youhas97/autonom-taxi/sketch/components.txt

Sensormodul:
    -ATMega1284, AVR
        http://ww1.microchip.com/downloads/en/DeviceDoc/doc8059.pdf
    -GP2Y0A41SK, Optisk avståndsmätare 4-30 cm (höger)
        https://docs.isy.liu.se/pub/VanHeden/DataSheets/sharp-GP2Y0A41SK0F.pdf
    -GP2Y0A02YK, Optisk avståndsmätare 20-150 cm (framåt)
        https://docs.isy.liu.se/pub/VanHeden/DataSheets/gp2y0a02_e.pdf
    -Halleffektsensor (medföljer chassi)
    -LCD JM162A, 2 rader x 16 tecken
        https://docs.isy.liu.se/pub/VanHeden/DataSheets/jm162a.pdf
        https://docs.isy.liu.se/pub/VanHeden/DataSheets/hd44780_komplett.pdf

Kommunkationsmodul:
    -Raspberry Pi 3 (medföljer chassi)
        https://www.raspberrypi.org/documentation/hardware/raspberrypi/README.md
    -Raspberry Pi Camera V2 Video Module
        https://www.raspberrypi.org/documentation/hardware/camera/README.md
    -Raspberry Pi GPIO
        https://www.raspberrypi.org/documentation/hardware/raspberrypi/gpio/README.md
    -TXB0104 Level Shifter (2st)
        https://www.adafruit.com/product/1875

Styrmodul:
    -ATMega1284, AVR
    -Motor (medföljer chassi)
    -Servo (medföljer chassi)
    -JTAG ICE (debug/flashning)
    -LCD JM162A

Gemensamt:
    -IQEXO-3, Kristalloscillator
        https://docs.isy.liu.se/pub/VanHeden/DataSheets/exo3.pdf
