youhas97/autonom-taxi/doc/tekniskrapport/sections/abstract.tex

\documentclass[kravspec/krav.tex]{subfiles}

\begin{document}

\vspace*{4cm}
\renewcommand{\abstractname}{\Large Sammanfattning}
\thispagestyle{empty}
\begin{abstract}
    \vspace*{1cm} \noindent
    En autonom taxibil som navigerar i ett känt rutnät har konstruerats med
    hjälp av två mikrokontroller och en Raspberry Ii. Banan som bilen kör på är
    förutbestämd där vägmarkeringarna är markerade med tejp. Banan består inte
    av några korsningar men banan kan bestå av rondeller. Bilen använder sig av
    en kamera där bilderna behandlas för att känna igen vägmarkeringarna.
    Därefter får bilen sina reglerparametrar från bildbehandlingen och från
    IR-sensorerna. Detta dokument beskriver de tekniska detaljerna i både
    hårdvaran och mjukvaran av taxibilen.
\end{abstract}
\newpage
\end{document}
