youhas97/autonom-taxi/doc/common/format_tikz.tex

\usepackage{tikz}

\tikzstyle{module}=[
    draw,
    rectangle,
    minimum width=30mm,
    minimum height=40mm,
    text width=30mm,
    align=center
]
\tikzstyle{branch}=[fill,shape=circle,minimum size=3pt,inner sep=0pt]
