youhas97/autonom-taxi/doc/common/sections/identity.tex

\documentclass[kravspec/krav.tex]{subfiles}

%tabell för projektidentitet
\newenvironment{projektidentitet}{%
{\ }\vspace{30mm}
\renewcommand{\arraystretch}{2}
\begin{center}
  {\huge Projektidentitet\\[1ex]}
  \textsl{\VARgruppnummer, \LIPSdatum, \VARprojekttitel}\\[1cm]
    \begin{tabular}{lp{60mm}r}
      \hline
      \textbf{Namn} &
      \textbf{Ansvarsområde} &
      \textbf{Epost} \\
	\hline
      }%
      {%
      \hline
    \end{tabular}
\end{center}
}
\newcommand{\gruppmedlem}[3]{{#1} & {#2} & {#3} \\}

\begin{document}

\thispagestyle{empty}

\begin{projektidentitet}
\gruppmedlem{\VARprojektledare}{Projektledare och kundkontakt}
    {\href{mailto:\VARprojektledaremail}
    {\texttt{\VARprojektledaremail}}}
\gruppmedlem{\VARkundansvarig}{Testansvarig}
    {\href{mailto:\VARkundansvarigmail}
    {\texttt{\VARkundansvarigmail}}}
\gruppmedlem{\VARarkitekt}{Arkitekt}
    {\href{mailto:\VARarkitektmail}
    {\texttt{\VARarkitektmail}}}
\gruppmedlem{\VARdokumentansvarig}{Dokumentansvarig}
    {\href{mailto:\VARdokumentansvarigmail}
    {\texttt{\VARdokumentansvarigmail}}}
\gruppmedlem{\VARgranssnitt}{Gränssnitt}
    {\href{mailto:\VARgranssnittmail}
    {\texttt{\VARgranssnittmail}}}
\gruppmedlem{\VARhardware}{Hårdvara}
    {\href{mailto:\VARhardwaremail}
    {\texttt{\VARhardwaremail}}}
\gruppmedlem{\VARelektronik}{Elektronik}
    {\href{mailto:\VARelektronikmail}
    {\texttt{\VARelektronikmail}}}
\end{projektidentitet}

\begin{center}
\vspace{0.5cm}
{\href{mailto:\VARdokumentansvarigmail,\VARarkitektmail,\VARprojektledaremail,
    \VARgranssnittmail,\VARprojektledaremail,\VARhardwaremail,
    \VARelektronikmail,\VARkundansvarigmail}{
\texttt{E-postadress till gruppen}}}\\

{\href{\VARgrupphemsida}{
\texttt{Grupphemsida: Git-repo för projekt}}}\\[1cm]

{\textbf{Kund:} \VARbestallare}\\[0.5ex]
{\textbf{Kontaktperson hos kund:} \VARkontaktperson}\\[1cm]

{\textbf{Kursansvarig:} \VARkursansvarig}\\[1ex]
{\textbf{Handledare:} \VARhandledare}

\end{center}
\newpage
\end{document}
