youhas97/autonom-taxi/doc/common/sections/frontpage.tex

\documentclass[kravspec/krav.tex]{subfiles}

\begin{document}
\begin{titlepage}
\thispagestyle{empty}
\begin{center}
    %logo
    \\[1.0cm]

    %heading
    \textsc{\Large TSEA29}\\[1.5cm]
    \textsc{\large Konstruktion med mikrodatorer}\\[2cm]
    
    %title
    { \huge \bfseries \LIPSdokumenttyp}\\[0.6cm]
    { \LARGE \VARprojekttitel}\\[2cm]

    %date
    {\large \LIPSdatum}\\[2ex]
    {\textbf{Redaktör: \VARprojektledare}}\\[2ex]
    {\VARgruppnummer}\\[2ex]
    {\textsl Version \LIPSversion}\\[2cm]

    {\large Status}\\[1.5ex]
    {\renewcommand{\arraystretch}{1.6}
    \begin{tabular}{|*{3}{p{40mm}|}}
    \hline
    Granskad & \LIPSgranskare & \LIPSgranskatdatum \\
    \hline
    Godkänd & \LIPSgodkannare & \LIPSgodkantdatum \\
    \hline
    \end{tabular}
    }
    
\end{center}
\end{titlepage}
\newpage

\end{document}
