youhas97/autonom-taxi/doc/tekniskrapport/figures/SequenceDiagramClient.pdf

## Fjärrklient

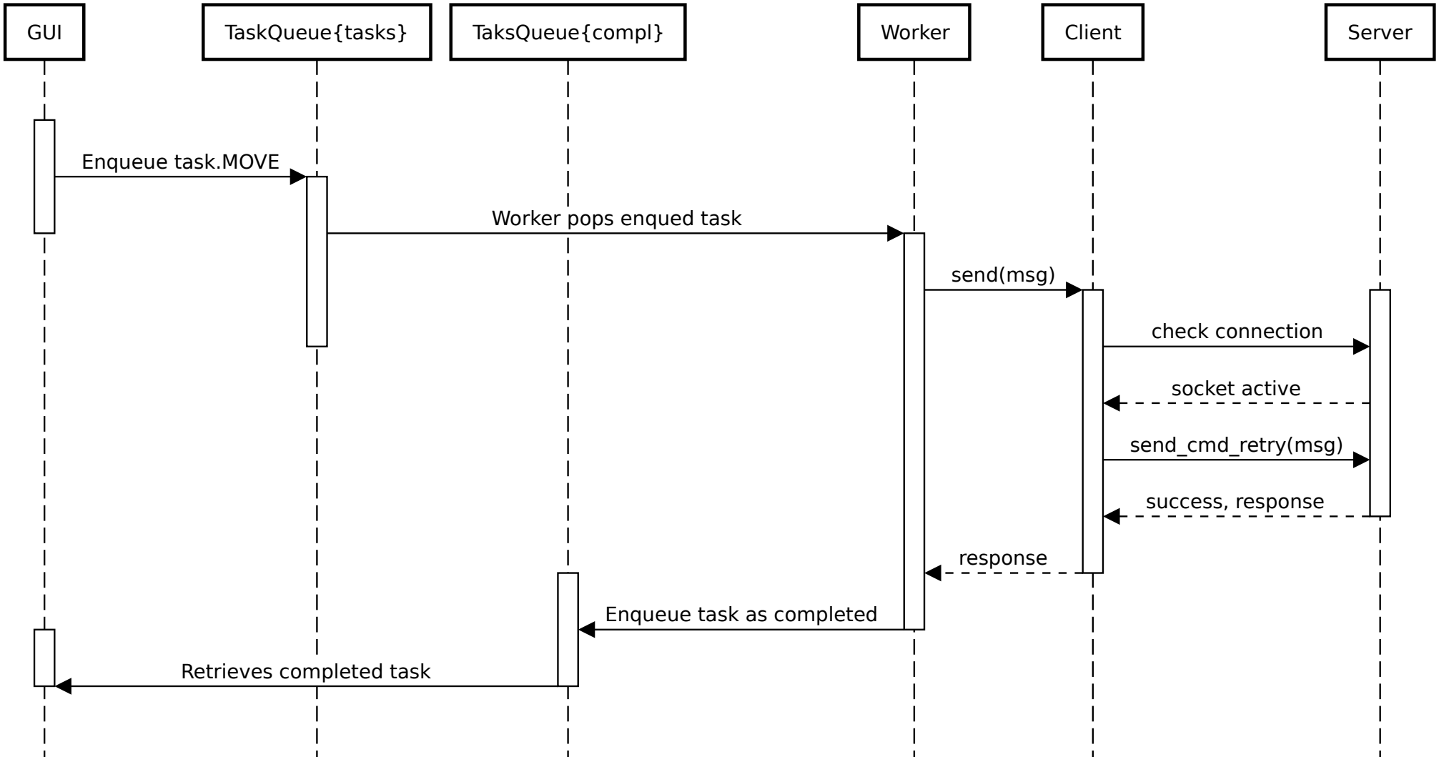
[picture p11: figure]
GUI; TaskQueue{tasks}; TaksQueue{compl}; Worker; Client; Server; Enqueue task.MOVE; Worker pops enqued task; send(msg); check connection; socket active; send_cmd_retry(msg); success, response; response; Enqueue task as completed; Retrieves completed task
