youhas97/autonom-taxi/doc/tekniskrapport/sections/appendices.tex

\documentclass[main.tex]{subfiles}
\renewcommand\appendixtocname{Bilagor}

\begin{document}

\pagestyle{empty}

\begin{appendices}
    \newpage
    \section{Bilaga. Kommandon för SPI}
    \label{bcmds}
    \input{tekniskrapport/figures/bcmds.tex}

    \newpage
    \section{Bilaga. Kommandon för server}
    \label{scmds}
    \input{tekniskrapport/figures/scmds.tex}

    \begin{landscape}
    \section{Bilaga. Kretsscheman}
    
    \subsection{Kommunikationsmodul}
    \label{cdiag:comm}
	    

    \subsection{Styrmodul}
    \label{cdiag:ctrl}
	    

    \subsection{Sensormodul}
    \label{cdiag:sens}
	    

    \end{landscape}
\end{appendices}

\end{document}
