youhas97/autonom-taxi/doc/tekniskrapport/sections/theory.tex

\documentclass[\docdir/tech.tex]{subfiles}

\begin{document}

\section{Teori}
Projektet använder vissa redan existerande funktioner och bibliotek för att
underlätta arbetet för projektgruppen. Nedan finns förklaringar på hur dessa
fungerar.

\subsection{PD-regulator}

Regleringen fungerar genom att räkna ut ett värde $v[n]$ med hjälp av ett
felvärde $e[t]$ så att 
\begin{equation*} v[n] = k_p \cdot e[n] + k_d \cdot (e[n]-e[n-1])\end{equation*} 
där $k_p$ och $k_d$ är konstanter(K-proportionell och K-derivata). Den första
termen står för att justera utefter det nuvarande felet. Den andra termen står
för att justera utefter den nuvarande förändringen av felet.

\end{document}
