youhas97/autonom-taxi/doc/kravspec/sections/requirements.tex

\documentclass[kravspec/krav.tex]{subfiles}

\begin{document}
\clearpage
\section{Prestandakrav}
Nedan följer de prestandakrav taxibilen bör uppnå vid avslutat projekt.

\begin{reqlist}
    \req{Bilen ska under fyra försök klara av att utföra ett uppdrag, som
    specificerat i banspecifikationen, åtminstone tre gånger.
    Banspecifikationen skickas in separat till beställaren.}
    \req{Bilen ska endast använda kortaste vägen under uppdraget.}
    \reqspec{original}{2}{Bilen ska klara uppdraget fyra gånger på fyra försök.}
\end{reqlist}

\section{Krav på utökning}
Nedan följer de krav som berör möjligheten att utöka enheten efter att
produkten är levererad.

\begin{reqlist}
    \req{Enheten ska bestå av separata moduler som kommunicerar via ett
    gränssnitt för att tillåta smidiga utbyten av moduler. Gränssnittet
    specificeras i det tekniska dokumentet.}
\end{reqlist}

\section{Resurser}
Projektgruppen skall hålla sig inom följande resurskrav.

\begin{reqlist}
    \req{Projektgruppens medlemmar skall spendera 160 timmar vardera på
    projektet efter beslutspunkt 2.}
\end{reqlist}

\section{Leveranskrav}
Följande leveranskrav skall uppnås.

\begin{reqlist}
    \req{Tidsrapporter som redovisar föregående veckas arbetad tid ska
    levereras varje måndag från och med vecka 45 till och med vecka 51 2018.}
    \req{Statusrapporter som redovisar projektets nuvarande status ska
    levereras vid begäran.}
    \req{De första versionerna av projektplanen, tidplanen och systemskissen
    ska levereras till beställaren senast 27 september 2018.}
    \req{De slutgiltiga versionerna av projektplanen, tidplanen och en
    systemskissen ska levereras till beställaren senast 4 oktober 2018.}
    \req{Den första versionen av designspecifikationen skall levereras till
    handledaren senast 6 november 2018.}
    \req{Den slutgiltiga versionen av designspecifikationen skall levereras
    till handledaren senast 9 november 2018.}
    \req{Teknisk dokumentation och användarhandledning ska levereras senast 13
    december 2018.}
    \req{Verifiering av kraven ska ske senast dagen innan redovisning som
    kommer att ske vecka 51 2018.}
    \req{En efterstudie för projektet skall lämnas till beställaren senast 20
    december 2018.}
    \req{Hårdvara och utrustning använda för taxin skall återlämnas senast den
    21 december.}
\end{reqlist}

\newpage % avoid pagebreak before table (may not be needed later)
\section{Dokumentation}
\label{sec:doc}
Nedan följer en lista av de dokument som skall medfölja produkten vid leverans.
{\renewcommand{\arraystretch}{1.6}
\begin{longtable}{p{4.5cm}p{1.5cm}p{5cm}p{2.2cm}p{1.2cm}}
    \bfseries Dokument &
    \bfseries Språk &
    \bfseries Syfte &
    \bfseries Målgrupp &
    \bfseries Format \\\hline
    Teknisk dokumentation &
    Svenska &
    Ge konstruktionsunderlag, samt dokumentation för underhåll och
    felsökning. &
    Beställare &
    PDF
    \\
    Användarhandledning &
    Svenska &
    Ge beskrivning av produktens användning. &
    Beställare, användare &
    PDF
    \\
    Designspecifikation &
    Svenska &
    Beskriva implementeringen av hårdvaran samt mjukvaran till systemet. &
    Underhållare, utvecklare &
    PDF
    \\
    Projektplan &
    Svenska &
    Beskriva hur projektet kommer att utföras och vilka strategier som
    tillämpas &
    Beställare &
    PDF
    \\
    Tidplan &
    Svenska &
    Planera hur arbetet ska fördelas och när det ska utföras. &
    Löne\-avdelning, projekt\-ledaren &
    XLS
    \\
    Systemskiss &
    Svenska &
    En skiss över implementationen av systemet &
    Beställare, utvecklare &
    PDF
    \\
    
    \endhead
\end{longtable}}

\noindent
Följande dokumentationskrav skall uppnås.
\begin{reqlist}
    \req{All dokumentation som lämnas in ska utgå från LIPS-modellen}
\end{reqlist}

\end{document}
