youhas97/autonom-taxi/doc/common/format.tex

% svensk encoding, svenska titlar
\usepackage[utf8]{inputenc}
\usepackage[swedish]{babel}

% matte
\usepackage{mathtools}

\usepackage{scalerel}

% separera filer, subfile kommando
\usepackage{subfiles}

% sidomargins
\usepackage[total={16cm, 21cm}]{geometry}

% page header and foot
\usepackage{fancyhdr}
\pagestyle{fancy}
\renewcommand{\headrulewidth}{0.2pt}
\renewcommand{\footrulewidth}{0.2pt}
\rhead{\sc \LIPSdatum}
%\chead{\textsl{\VARprojekttitel}}
\lhead{\textbf{\sc\footnotesize \leftmark}}
\lfoot{\textbf{\sc \VARkurskod}\\ \LIPSdokumenttyp}
\rfoot{\textbf{\sc \VARgruppnummer}\\ \textsl{\VARprojekttitel}}

% referenser
\newcommand{\bibfile}{common/ref}
\usepackage[numbib,notlof,notlot,nottoc]{tocbibind}

% figurer
\usepackage{graphicx} % pdf-import
\usepackage{float} % Figure H option
\usepackage{longtable} % splitta tabeller vid sidbrytning

% labeling env för definitioner
\usepackage{scrextend}
\addtokomafont{labelinglabel}{\bfseries}

% highlighting for links
\usepackage[
    colorlinks=true,
    urlcolor=blue,
    linkcolor=black,
    citecolor=blue,
    filecolor=blue]{hyperref}
\hypersetup{breaklinks=true}
\urlstyle{same}

% kommandon med godtyckliga antal parametrar
\usepackage{xparse}

% diagram för data bitstreams
\usepackage{bytefield}

% landscape appendices
\usepackage[paper=portrait,pagesize]{typearea}
\usepackage{appendix}
\usepackage{pdflscape}

\usepackage{array}

\usepackage{wrapfig}

\input{common/format_tikz.tex}
\input{common/format_command.tex}
