youhas97/autonom-taxi/doc/efterstudie/sections/sammanfattning.tex

\documentclass[efterstudie/studie.tex]{subfiles}

\begin{document}
\section{SAMMANFATTNING}
text
\subsection{De tre viktigaste erfarenheterna}
text

\subsection{Goda råd till de som ska utföra ett liknande projekt}
\end{document}
