youhas97/autonom-taxi/doc/systemskiss/sections/mod_hist.tex

\documentclass[systemskiss/skiss.tex]{subfiles}

\begin{document}

\begin{dokumenthistorik}
    \versioninfo{0.1}{2018-09-26}{Första utkast.}{Grupp 2}{DD, EH, JA}
    \versioninfo{0.2}{2018-10-02}{Ändring av figurerna, specifierat sensorer
    samt gränssnitt. Lagt till beskrvining av mjukvara. Meningar har
    omformulerats enligt kommentarer.}{Grupp 2}{\LIPSgranskare}
    \versioninfo{1.0}{2018-10-08}{Lagt till ordometer enligt kommentar}{Grupp
    2}{JA}
\end{dokumenthistorik}

\end{document}
