youhas97/autonom-taxi/doc/systemskiss/sections/laptop.tex

\documentclass[systemskiss/skiss.tex]{subfiles}

\begin{document}
\section{Bärbar dator}
Den bärbara datorn ska användas för att kommunicera med bilen under körning. Den ska kunna skicka och ta emot styrvärden och kunna agera kontroller när bilen går in i manuellt läge.
\subsection{Översiktlig beskrivning av delsystemet}
\begin{figure}[h]
    \centering
    
    \caption{Bild på den bärbara datorn}
    \label{fig:laptopskiss}
\end{figure}
\noindent
Datorn ska ha någon typ av gränssnitt för att kunna mata in den bana som ska
användas under körningen. Kartan och position skulle kunna ritas grafiskt m
edan inmatning av data och visning av sensorvärden skulle kunna ske via en
CLI-gränssnitt på terminalen. Det vore önskvärt om hela gränssnittet är
grafiskt. Datorn ska även kunna visa kartan och kunna visa bilens position i banan. Kommunikationen mellan datorn och bilen ska ske trådlöst via blåtand eller wifi. Data ska kunna skickas fortlöpande från bilen så att datorn kan visa vilka värden bilens sensorer har. När bilen växlar över till manuellt läge ska datorn agera som kontroll och då ska styrdatan skickas trådlöst från datorn till bilen. Datorn är kopplad till bilens komuniaktionsmodul.

\end{document}
