youhas97/autonom-taxi/doc/tekniskrapport/figures/client-box-line-diagram.pdf

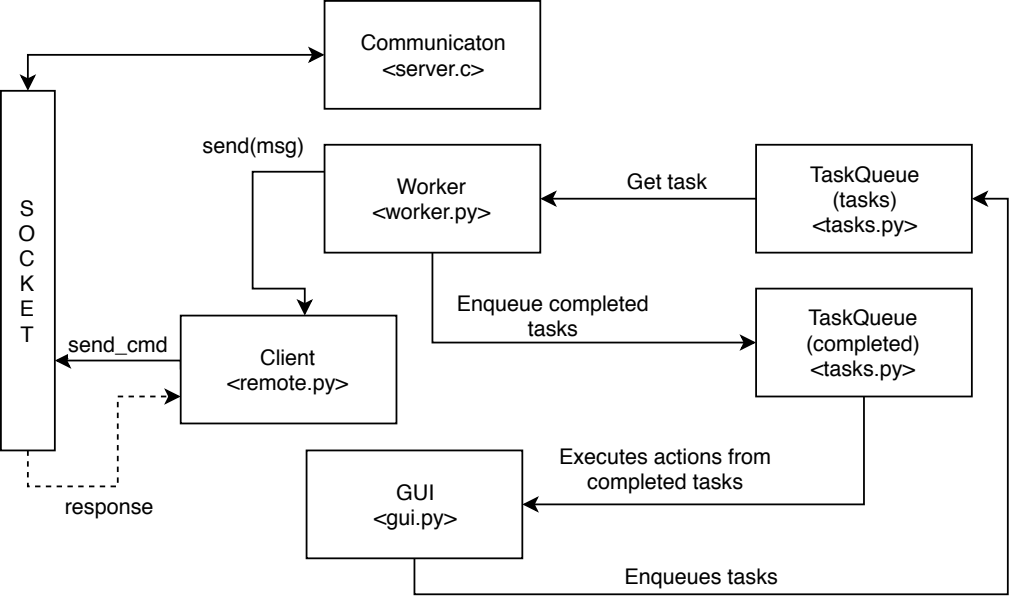
[picture p20: figure]
Worker <worker.py>; TaskQueue (tasks) <tasks.py>; GUI <gui.py>; send_cmd; Client; <remote.py>; response; Communicaton <server.c>; TaskQueue (completed) <tasks.py>; Enqueues tasks; Executes actions from completed tasks; Get task; Enqueue completed tasks; send(msg)
