youhas97/autonom-taxi/doc/projektplan/figures/orgplan.pdf

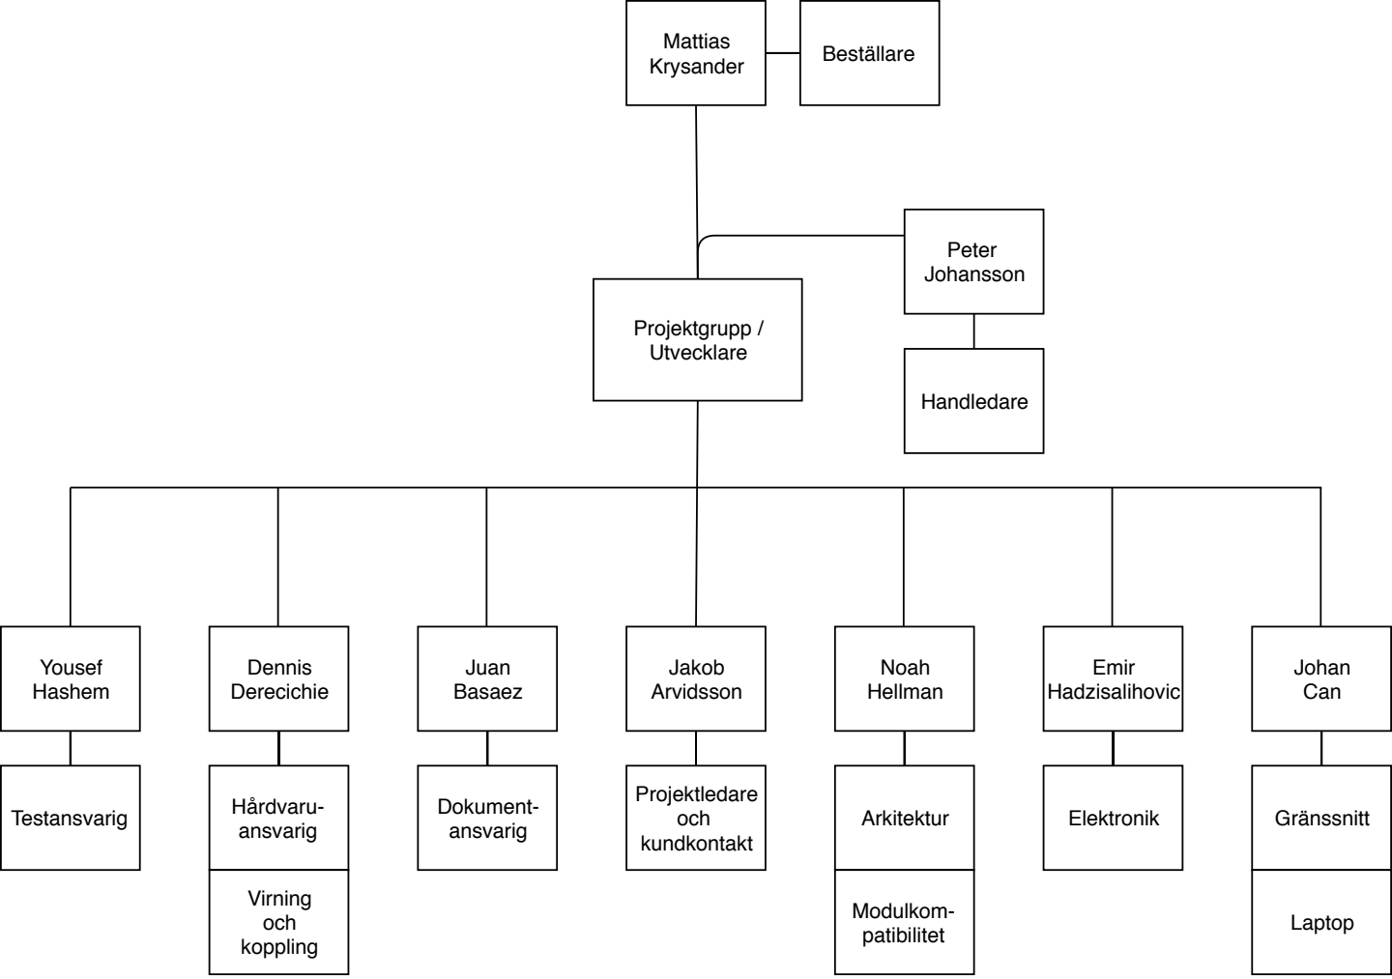
[picture p26: figure]
Yousef Hashem; Dennis Derecichie; Juan Basaez; Jakob Arvidsson; Noah Hellman; Emir Hadzisalihovic; Johan Can; Projektgrupp / Utvecklare; Testansvarig; Hårdvaru-; ansvarig; Dokument- ansvarig; Projektledare och kundkontakt; Arkitektur; Elektronik; Gränssnitt; Peter Johansson; Handledare; Laptop Modulkom- patibilitet; Virning och koppling; Mattias; Krysander; Beställare
