youhas97/autonom-taxi/doc/systemskiss/figures/systemomgivning.pdf

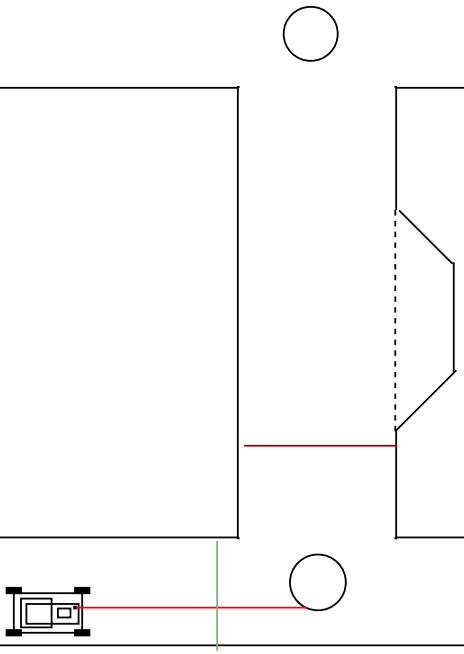
[picture p27: figure]
