youhas97/autonom-taxi/doc/tidsrapport/tidsrapport.xlsx

Sheet: Tidsrapport
HELA GRUPPEN – TID |  |  |  |  |  |  |  |  |  |  |  | DENNIS DERECICHEI
NAMN | VECKONUMMER (NÄR) |  |  |  |  |  |  |  |  |  | Summa | NAMN | VECKONUMMER (NÄR)
 | 41 | 42 | 43 | 44 | 45 | 46 | 47 | 48 | 49 | 50 | timmar |  | 41 | 42 | 43 | 44 | 45 | 46 | 47 | 48 | 49 | 50
Jakob Arvidsson | 15 | 13 | 0 | 0 | 10 | 27 | 30 | 31 | 20 | 0 | 146 | Måndag | 4 | 5 |  |  | 4 | 3 | 6 | 5 | 2
Juan Basaez | 12 | 5 | 0 | 0 | 13 | 23 | 24 | 30 | 40 | 0 | 147 | Tisdag | 4 |  |  |  |  | 8 | 5 | 5 | 3
Johan Can | 11 | 4 | 0 | 6 | 11 | 14 | 24 | 22 | 34 | 0 | 126 | Onsdag |  |  |  |  |  | 6 | 6 | 5 | 3
Dennis Derecichei | 17 | 5 | 0 | 4 | 13 | 28 | 30 | 24 | 20 | 0 | 141 | Torsdag | 5 |  |  |  | 3 | 5 | 7 | 3 | 4
Emir Hadzisalihovic | 11 | 5 | 0 | 14 | 8 | 24 | 29 | 15 | 30 | 0 | 136 | Fredag | 4 |  |  | 4 | 6 | 6 | 6 | 6 | 8
Yousef Hashem | 14 | 5 | 0 | 4 | 9 | 21 | 22 | 20 | 40 | 0 | 135 | Lördag
Noah Hellman | 16 | 13 | 0 | 15 | 13 | 27 | 26 | 29 | 10 | 0 | 149 | Söndag
Summa timmar | 96 | 50 | 0 | 43 | 77 | 164 | 185 | 171 | 194 | 0 | 980 | Summa timmar | 17 | 5 | 0 | 4 | 13 | 28 | 30 | 24 | 20 | 0
JAKOB ARVIDSSON |  |  |  |  |  |  |  |  |  |  |  | EMIR HADZISALIHOVIC
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
