youhas97/autonom-taxi/doc/designspec/sections/comm.tex

\documentclass[designspec/spec.tex]{subfiles}

% Detta avsnitt bör innehålla:
%
%   -En beskrivning av hur processorerna kommunicerar med varandra (gäller även
%   kommunikation med PC:n om Blåtand används), protokoll och master/slave
%   förhållande.
%
%   -En beskrivning av vilken information (data, styrinformation, sensorvärden
%   etc.) som ska skickas mellan blocken, samt hur och vilken väg den ska
%   skickas. (Detaljer kring informationskodning och överföringsprotokoll kan
%   gruppen få utveckla under projektets gång).

\newcommand{\wlcomm}[3]{\mono{#1} & #2 & #3 \\}

\begin{document}

\section{Kommunikation}
Kommunikation kommer att ske mellan fjärrklienten och kommunikationsmodulen
samt mellan kommunikationsmodulen och vardera mikrokontroller i styr- och
sensormodulen. Denna sektion specificerar hur kommunikationen ska uppnås samt
hur informationen som växlas skall uttryckas av sändaren och tolkas av
mottagaren.

\subsection{Trådlös länk}
Taxin och fjärrklienten kommer att kommunicera via TCP/IP.
Kommunikationsmodulen och fjärrklienten ansluter till ett gemensamt WLAN.
Därefter binder kommunikationsmodulen sin IP-address och en port till en sockel
som fjärrklienten kan ansluta till.

\subsubsection{Protokoll}
\label{sec:wlproto}
Kommunikationsmodulen kommer att vänta på inkommande instruktioner via sockeln
och exekvera dem när de tas emot. Instruktioner skickas i form av strängar och
kan inkludera argument. För instruktioner utan argument skickas endast en
sträng med instruktionens namn; till exempel \mono{get\_sensor\_data}. För
instruktioner med argument består strängen av instruktionens namn följt av ett
kolon och ett eller flera argument. Flera argument separeras med kommatecken;
till exempel \mono{set\_mission:\commIgnore,\commIgnore,\commPark}.

{\setlength{\tabcolsep}{12pt}
\renewcommand{\arraystretch}{1.6}
\begin{longtable}{p{3.5cm}p{2.8cm}p{7cm}}
    \bfseries Instruktion & \bfseries Argument & \bfseries Handling \\\hline
    \wlcomm{get\_sensor\_data}{inga}{En sträng med mätvärden för varje sensor
    skickas tillbaka.}
    \wlcomm{get\_mission\_status}{inga}{En sträng med information om uppdraget
    skickas tillbaka, till exempel nuvarande position.}
    \wlcomm{set\_mission}{variabelt antal, kommandon}{Sätt en kö av kommandon
    som ska utföras vid stopplinjer. Kommandona är specificerade i sektion
    \ref{sec:comm-mission}.}
    \wlcomm{execute\_mission}{inga}{Utför uppdraget enligt kommandona i det
    nuvarande satta uppdraget.}
    \wlcomm{cancel\_mission}{inga}{Avbryt utförandet av uppdrag. Uppdraget kan
    återupptas igen med \mono{execute\_mission}.}
    \wlcomm{set\_speed\_delta}{felvärde}{Sätt felvärde för hastigheten,
    ignoreras om uppdrag är aktivt.}
    \wlcomm{set\_turn\_delta}{felvärde}{Sätt felvärde för svängradien,
    ignoreras om uppdrag är aktivt.}
    \wlcomm{set\_speed\_params}{$k_p$, $k_d$}{Sätt konstanter  för regleringen
    av hastigheten}
    \wlcomm{set\_turn\_params}{$k_p$, $k_d$}{Sätt konstanter för regleringen av
    svängradien}
\end{longtable}
}

\subsection{Mellan taxins moduler}
Mellan sensormodulen, kommunikationsmodulen och styrmodulen används
gränssnittet SPI. Kommunikationsmodulen agerar som \emph{master} medan
sensormodulen och styrmodulen agerar som \emph{slaves}. Varje modul är kopplad
till en gemensam SCLK-signal för synkronisering, en MISO-signal för data till
master:n och MOSI för data från master:n som visat i figur \ref{fig:bus_inter}.
Sensormodulen skickar sensorvärden till kommunikationsmodulen och
kommunikationsmodulen skickar styrkommandon till styrmodulen. Eventuellt kan
data överföras till sensormodulen eller från styrmodulen vid felsökning.
\begin{figure}[H]
    \centering
    \subfile{\figures/bus_spi}
    \caption{Den gemensamma databussen mellan modulerna.}
    \label{fig:bus_inter}
\end{figure}

\subsubsection{Från sensormodul till kommunikationsmodul}
Sensormodulen ska fortlöpande skicka värden för varje sensor till
kommunikationsmodulen. Figur \ref{bf:sens-comm} visar bitsekvensen som
sensormodulen skickar.

\begin{figure}[H]
    \centering
    \begin{bytefield}[endianness=big]{24}
        \bitheader{0,7,8,15,16,23} \\
        \bitbox{8}{$d_f$}
        \bitbox{8}{$d_r$}
        \bitbox{8}{$n$}
    \end{bytefield}
    \caption{Bitsekvensen för datan som skickas fortlöpande till
    kommunikationsmodulen till sensormodulen.}
    \label{bf:sens-comm}
\end{figure}

\paragraph{Frontavståndet $d_f$} är ett 8-bitars osignerat heltal som
representerar avståndet från sensorn på taxins framsida. Heltalet representerar
avståndet som frontsensorn läser i centimeter.

\paragraph{Sidoavståndet $d_r$} är ett 8-bitars osignerat heltal som
representerar avståndet från sensorn på taxins högersida. Heltalet
representerar avståndet som sidosensorn läser i centimeter.

\paragraph{Varvtalet $n$} är ett 8-bitars osignerat heltal som specificerar
antalet varv som taxins hjul har rullat sen förra sändelsen.

\subsubsection{Från kommunikationsmodul till styrmodul}
Kommunikationsmodulen ska skicka ett felvärde $e_v$ för hastigheten och ett
felvärde $e_r$ för styrradien till styrmodulen med jämna mellanrum. Styrenheten
ska försöka justera hastigheten och radien som specificerat av det senaste
mottagna värdet. Figur \ref{bf:comm-ctrl} visar bitsekvensen för datan som
sänds.

\begin{figure}[H]
    \centering
    \begin{bytefield}[endianness=big]{16}
        \bitheader{0,7,8,15} \\
        \bitbox{8}{$e_v$}
        \bitbox{8}{$e_r$}
    \end{bytefield}
    \caption{Bitsekvensen för datan som skickas fortlöpande från
    kommunikationsmodulen till styrmodulen.}
    \label{bf:comm-ctrl}
\end{figure}

\paragraph{Hastighetsfelet $e_v$} består av ett signerat 8-bitars heltal i
tvåkomplementsform. Värdet är ett felvärde för hastigheten som beräknas
$e_v=v_\textit{önskad}-v_\textit{nuvarande}$. Negativa värden betyder att bilen
kör för snabbt och positiva värden betyder att farten ska öka.

\paragraph{Styrfelet $e_r$} består av ett signerat 8-bitars heltal i
tvåkomplementsform. Värdet är ett felvärde för styrradien som beräknas av
kommunikationsmodulen utifrån bilens förhållande till väglinjerna. Ett
nollvärde betyder att hjulen står rätt, negativt att hjulen bör svänga mer åt
vänster och positivt att hjulen bör svänga mer åt höger.

\end{document}
