youhas97/autonom-taxi/doc/designspec/sections/appendices.tex

\documentclass[main.tex]{subfiles}
\renewcommand\appendixtocname{Bilagor}

\begin{document}

\pagestyle{empty}

\begin{appendices}
    \begin{landscape}

    \section{Bilaga. Kretsscheman}
    
    \subsection{Kommunikationsmodul}
    \label{cdiag:comm}
    

    \subsection{Styrmodul}
    \label{cdiag:ctrl}
    

    \subsection{Sensormodul}
    \label{cdiag:sens}
    

    \section{Bilaga. Flödesdiagram}

    \subsection{Fjärrklient}
    \label{flow:remote}
    

    \end{landscape}
\end{appendices}

\end{document}
