youhas97/autonom-taxi/doc/kravspec/format.tex

%tabell för krav
\newcounter{reqcat} % nummer för varje kravkategori
\newcounter{reqitem} % individuella kravnummer
\newenvironment{reqlist}
{
    \setlength{\tabcolsep}{12pt}
    \renewcommand{\arraystretch}{1.6}
    \stepcounter{reqcat}
    \setcounter{reqitem}{0}
    \begin{longtable}{p{8mm}p{13mm}p{9cm}p{18mm}}
        \bfseries Nr &
        \bfseries Modif. &
        \bfseries Krav &
        \bfseries Prioritet \\\hline
        \endhead
}{
    \end{longtable}
}
\newcommand{\reqspec}[3]{
    \stepcounter{reqitem}\thereqcat.\thereqitem & #1 & #3 & #2 \\
}
\newcommand{\req}[1]{\reqspec{original}{1}{#1}}
