youhas97/autonom-taxi/doc/kravspec/sections/intro.tex

\documentclass[kravspec/krav.tex]{subfiles}

\begin{document}
\section{Inledning}
Den här kravspecifikationen svarar på alla möjliga frågor angående
konstruktionen av den tidigare nämnda autonoma taxibilen. På följande sidor,
under varje enskild punkt, förklaras alla krav som produkten ska uppfylla,
allt som ska användas vid konstruktionen samt hur all hårdvara och mjukvara
ska vara kopplade vid användningen.

Här hittas alla förklaringar på  hur produkten ska konstrueras så att
beställaren av produkten kan komma överens med gruppen som ska vara
ansvarig för konstruktionen och på det sättet bekräfta att produkten ska
uppfylla hens krav.

\subsection{Parter}
Beställare av systemet är
\begin{list}{}
    \item \bfseries \VARbestallare
\end{list}\vspace{4mm}

\noindent
Utvecklingsgruppen består av
{\bfseries\begin{list}{}
   \item \VARprojektledare,
   \item \VARdokumentansvarig,
   \item \VARgranssnitt,
   \item \VARhardware,
   \item \VARelektronik,
   \item \VARkundansvarig,
   \item \VARarkitekt.
\end{list}}\vspace{4mm}

\noindent
Handledare till utvecklingsgruppen är
\begin{list}{}	
	\item \bfseries \VARhandledare
\end{list}\vspace{4mm}

\subsection{Syfte och Mål}
Målet är att konstruera en autonom taxibil som ska kunna köra i en bana och
plocka upp samt lämna av passagerare. I banan kan det förekomma hinder av olika
slag. Syftet med uppgiften är att fördjupa projektgruppens kunskaper inom
elektronik, programmering och framför allt samarbete inom en projektgrupp.

\subsection{Användning}
Konstruktionen ska användas och sättas på prov i en tävling mellan alla grupper
som tillhör samma projekttyp. Detta för att visa att konstruktionen fungerar
som den ska samt att kraven är uppfyllda.

\subsection{Bakgrundsinformation}
Projektet startades med att en beställare beskrev ett system och ställde krav
utifrån funktionen. Dessa krav måste vara tydliga för att minimera missförstånd
mellan beställare och utvecklare. Kraven antecknas, specificeras och
sammanställs i rapporten nedan.

\subsection{Definitioner}
\begin{labeling}{långt namn}
    \item[Taxin] Namnet som används på den radiostyrda bilen där systemet är
    implementerat.
    \item[Modul] Är en oberoende del i konstruktionen som består av minst en
    processor. Moduler ska vara lätta att byta ut mot andra moduler.
    \item[Vägnät] Den tvåfiliga banan som taxin ska köra på. Den består av vita
    vägar med svarta sidmarkeringar.
    \item[Hinder] Något som är placerat på vägen och förhindrar framkomsten för
    Taxin när den kör i vägnätet.
    \item[Autonom körning] Ett visst läge i konstruktionen där Taxin är menad
    att autonomt transportera passagerare.
    \item[Bärbara datorn] Den dator som är trådlöst ansluten till Taxin.
    \item[Fjärrstyrning] Styrning av Taxin ifrån den bärbara datorn. 
\end{labeling}

\end{document}
