youhas97/autonom-taxi/doc/tekniskrapport/figures/2018-12-13-170812_1920x1080_scrot.png

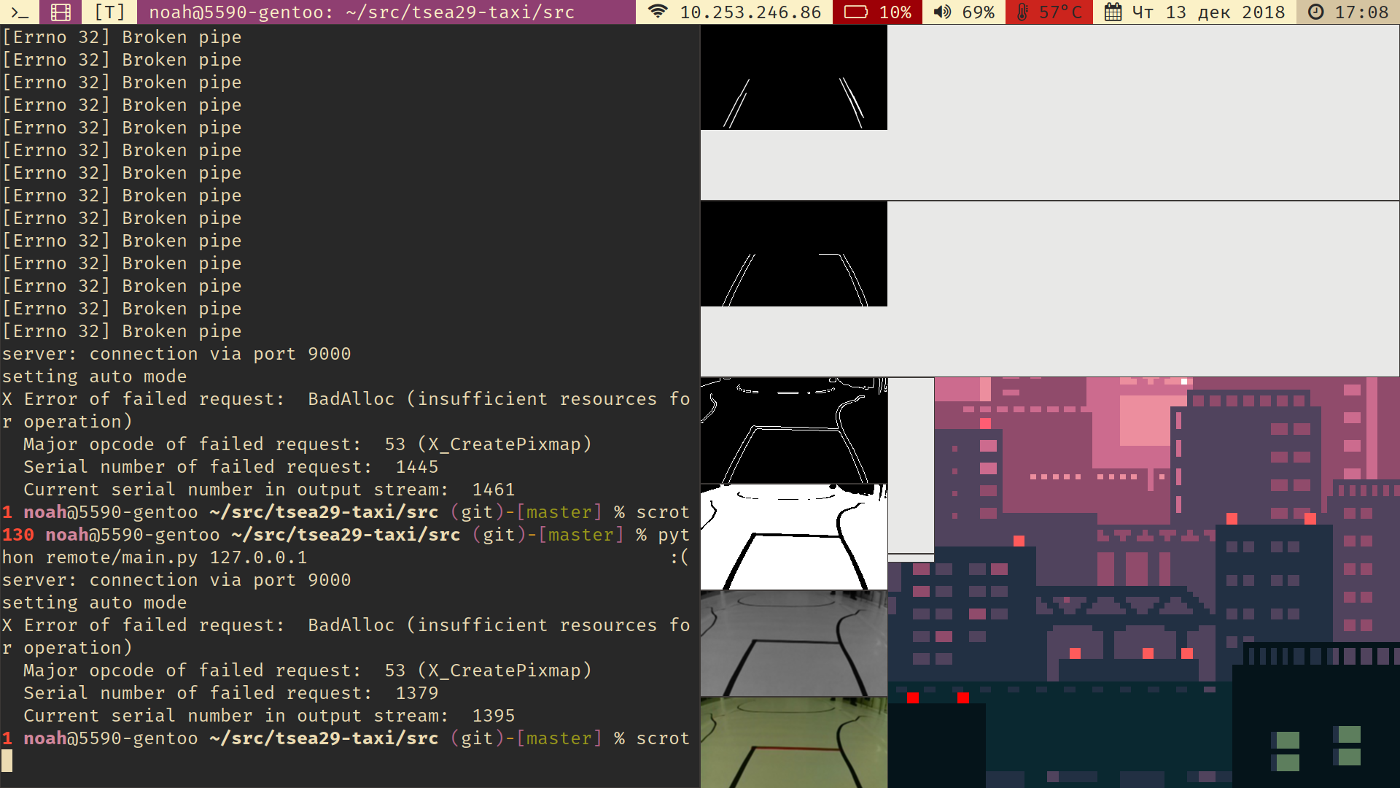
doc/tekniskrapport/figures/2018-12-13-170812_1920x1080_scrot.png
