youhas97/autonom-taxi/doc/tekniskrapport/figures/taxi2.jpg

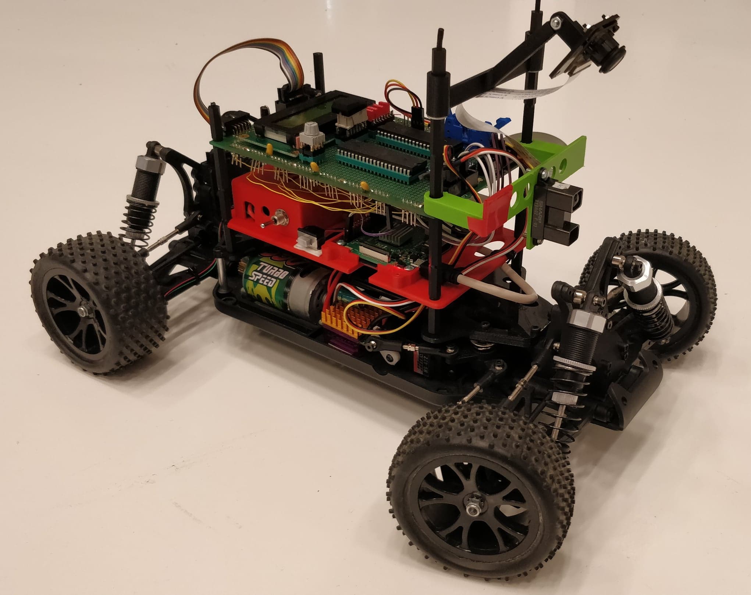
doc/tekniskrapport/figures/taxi2.jpg
