youhas97/autonom-taxi/doc/usermanual/man.tex

\documentclass[12pt]{article}

\input{common/vars.tex}
\input{usermanual/vars.tex}
\input{common/format.tex}
\input{usermanual/format.tex}

\begin{document}
\subfile{common/sections/frontpage}
\subfile{common/sections/identity}
\setcounter{page}{1}
\tableofcontents\newpage
\subfile{\sections/mod_hist}\clearpage
\subfile{\sections/dependencies}\clearpage
\subfile{\sections/intro}\clearpage
\subfile{\sections/flash}\clearpage
\subfile{\sections/remote}\clearpage
\end{document}
