youhas97/autonom-taxi/doc/usermanual/vars.tex

\newcommand{\LIPSdokumenttyp}{Användarmanual}
\newcommand{\LIPSversion}{0.1}
\newcommand{\LIPSdatum}{2018-12-05}
\newcommand{\LIPSgranskare}{}
\newcommand{\LIPSgodkannare}{\VARkontaktperson}
\newcommand{\LIPSgranskatdatum}{}
\newcommand{\LIPSgodkantdatum}{}
\newcommand{\docdir}{usermanual}
\newcommand{\figures}{\docdir/figures}
\newcommand{\sections}{\docdir/sections}
