youhas97/autonom-taxi/doc/usermanual/sections/mod_hist.tex

\documentclass[usermanual/man.tex]{subfiles}

\begin{document}

\begin{dokumenthistorik}
    \versioninfo{0.1}{2018-12-05}{Första utkast.}{Grupp 2}{DD}

\end{dokumenthistorik}
\newpage

\end{document}
