youhas97/autonom-taxi/doc/usermanual/sections/regler.tex

\documentclass[usermanual/man.tex]{subfiles}
\section{Reglerparametrar}
Beskriv hur man fortlöpande skickar uppdrag och reglerparametrar och vad de innebär
