youhas97/autonom-taxi/doc/usermanual/figures/kp-kd.png

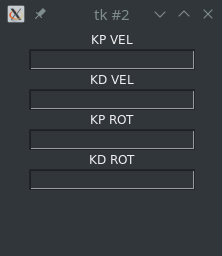
doc/usermanual/figures/kp-kd.png
