youhas97/autonom-taxi/doc/usermanual/figures/node_colors.png

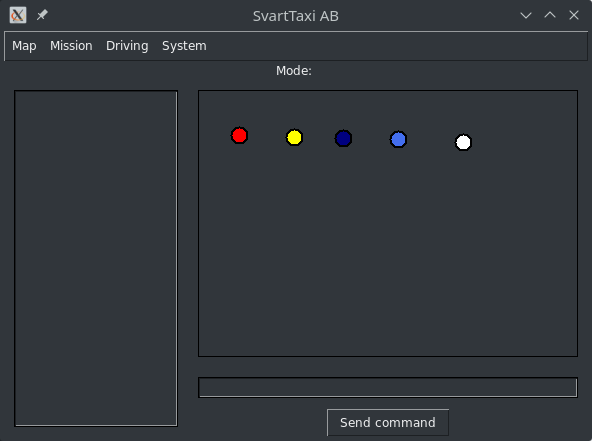
doc/usermanual/figures/node_colors.png
