youhas97/autonom-taxi/doc/usermanual/figures/roundabout.png

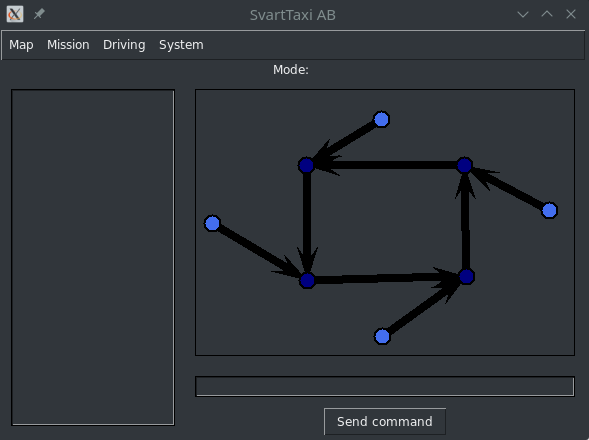
doc/usermanual/figures/roundabout.png
