youhas97/autonom-taxi/doc/tekniskrapport/figures/sens.pdf

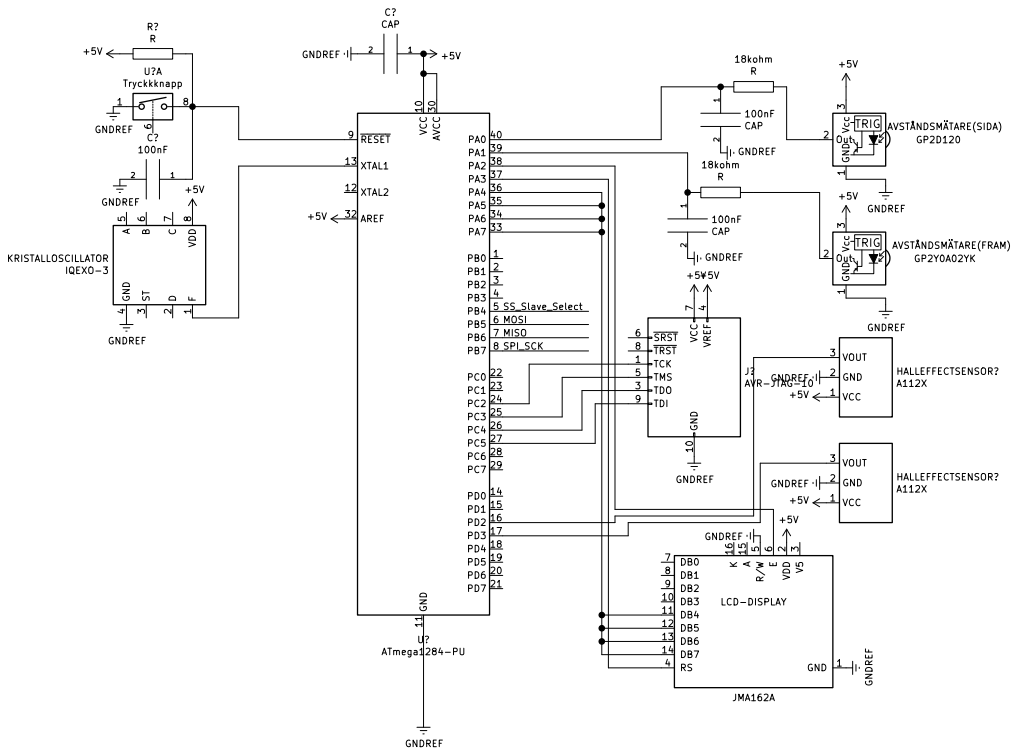
[picture p45: page 1]

F 1 D 2 ST 3 GND 4 A 5 B 6 C 7 VDD 8 KRISTALLOSCILLATOR
