youhas97/autonom-taxi/doc/tekniskrapport/figures/integration.pdf

# LCD

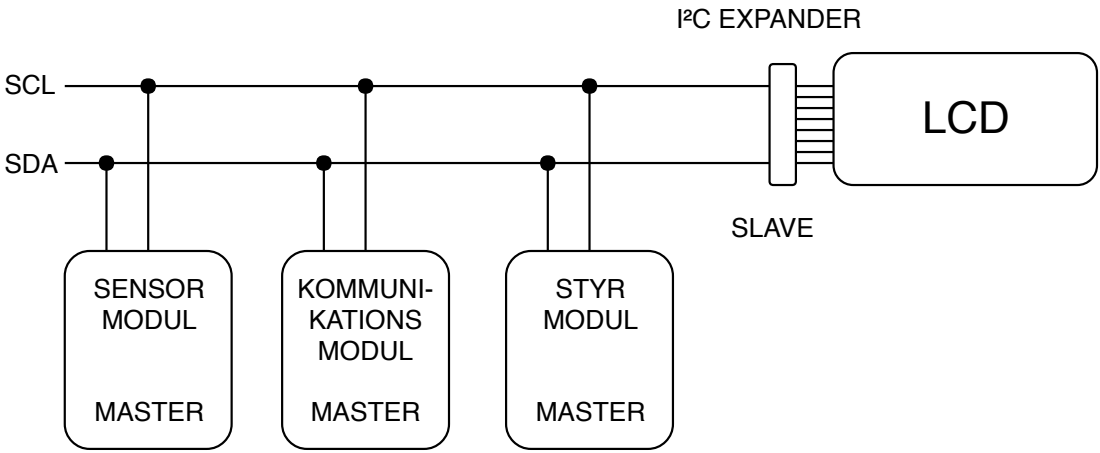
[picture p46: page 1]
SENSOR MODUL; MASTER; KOMMUNI- KATIONS MODUL; STYR MODUL; SCL; SDA; SLAVE; I²C EXPANDER
