youhas97/autonom-taxi/doc/tekniskrapport/figures/blockskiss.pdf

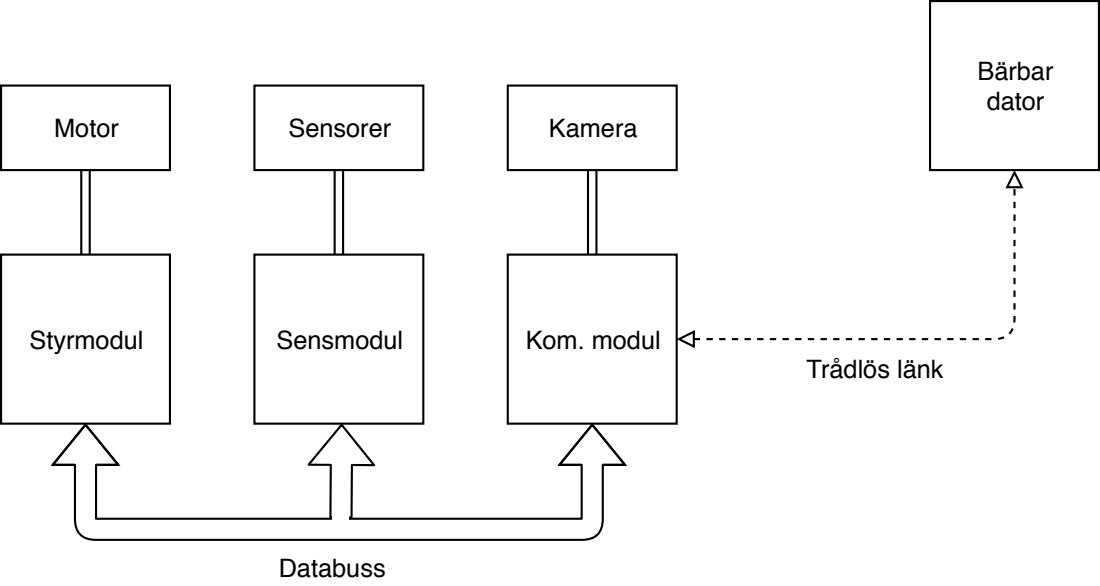
[picture p47: page 1]
Styrmodul; Sensmodul; Kom. modul; Bärbar dator; Motor; Sensorer; Kamera; Trådlös länk; Databuss
