youhas97/autonom-taxi/doc/kravspec/figures/overview-schema.pdf

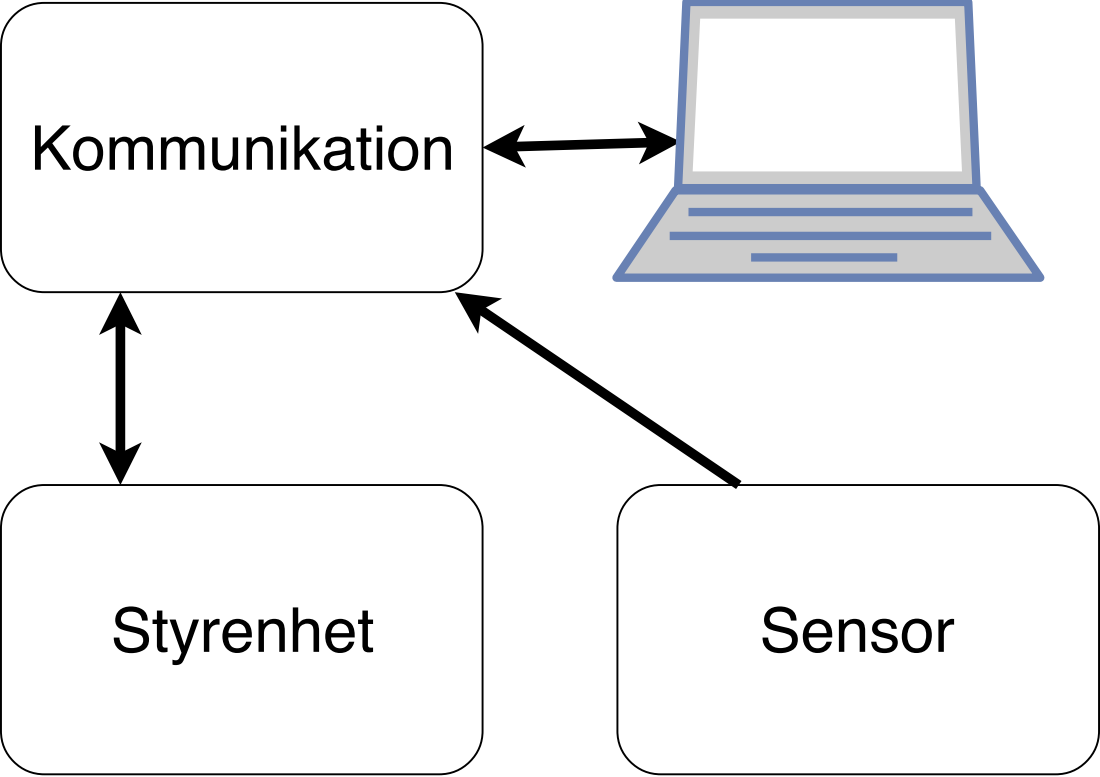
[picture p48: page 1]
Kommunikation; Styrenhet; Sensor
