youhas97/autonom-taxi/doc/systemskiss/figures/sensormodul.pdf

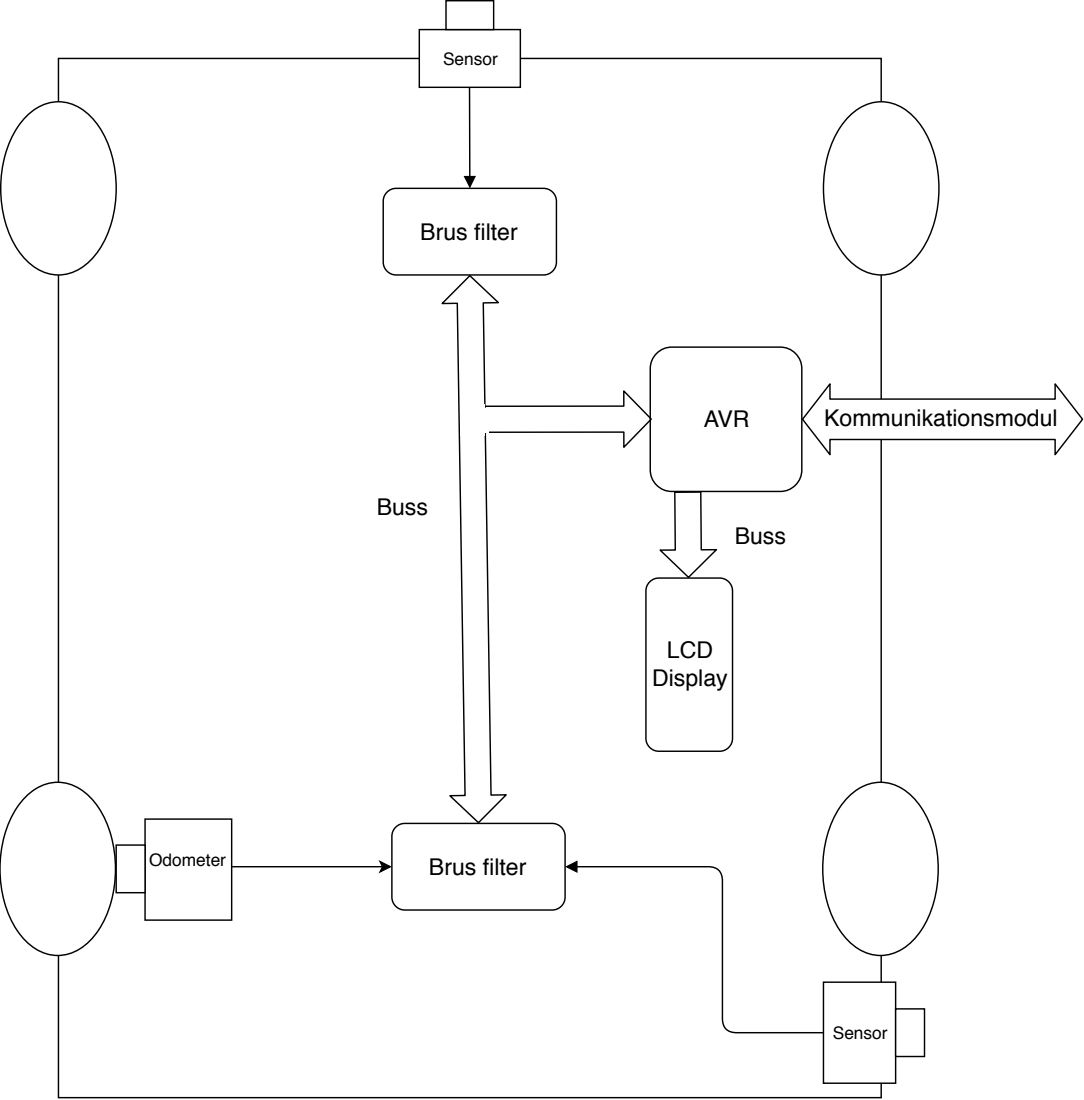
[picture p49: page 1]
Sensor; Brus filter; AVR; LCD Display; Buss; Kommunikationsmodul; Odometer
