youhas97/autonom-taxi/doc/systemskiss/figures/kommodul.pdf

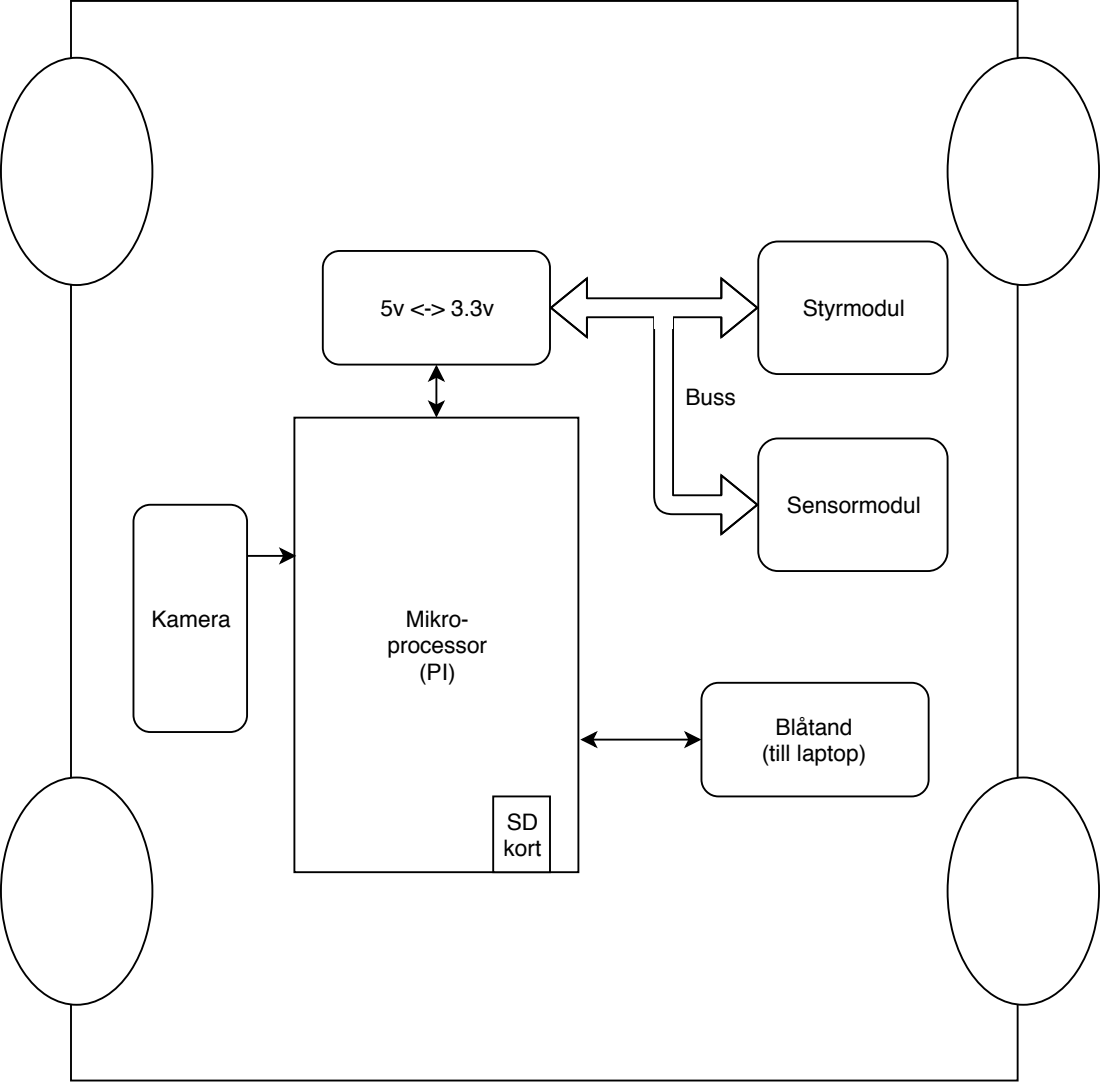
[picture p50: page 1]
Mikro- processor (PI); Blåtand (till laptop); Kamera; Styrmodul; Sensormodul; Buss; SD kort
