youhas97/autonom-taxi/doc/systemskiss/figures/taxibilen.pdf

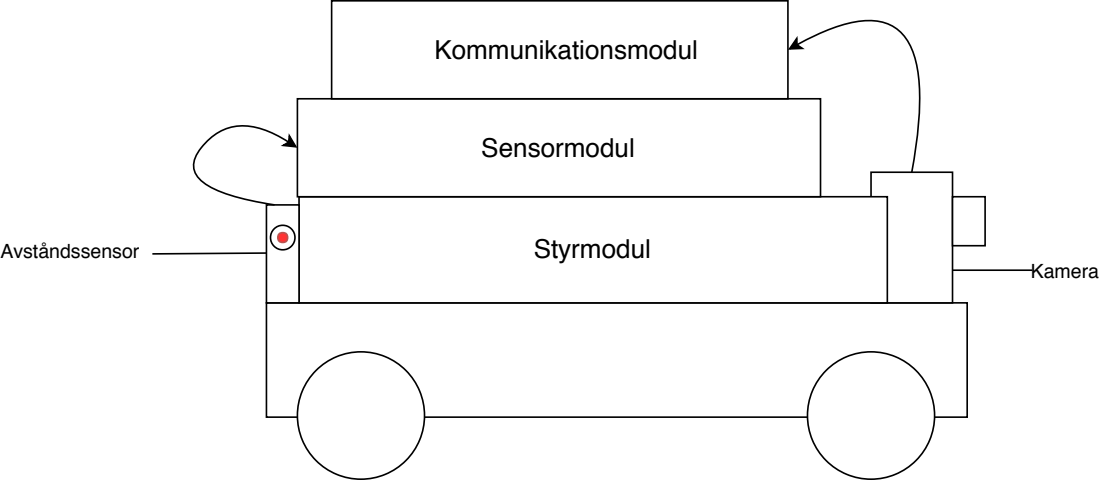
[picture p51: page 1]
Styrmodul; Sensormodul; Kommunikationsmodul; Avståndssensor; Kamera
