youhas97/autonom-taxi/doc/kravspec/figures/sensormodul.pdf

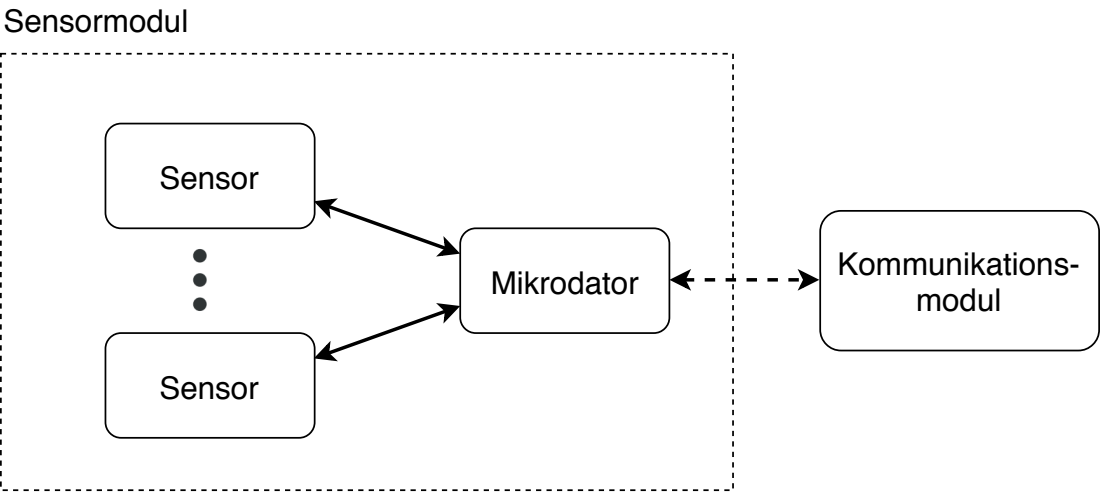
[picture p52: page 1]
Sensormodul; Sensor; Mikrodator; Kommunikations-; modul
