youhas97/autonom-taxi/doc/tekniskrapport/figures/styr.pdf

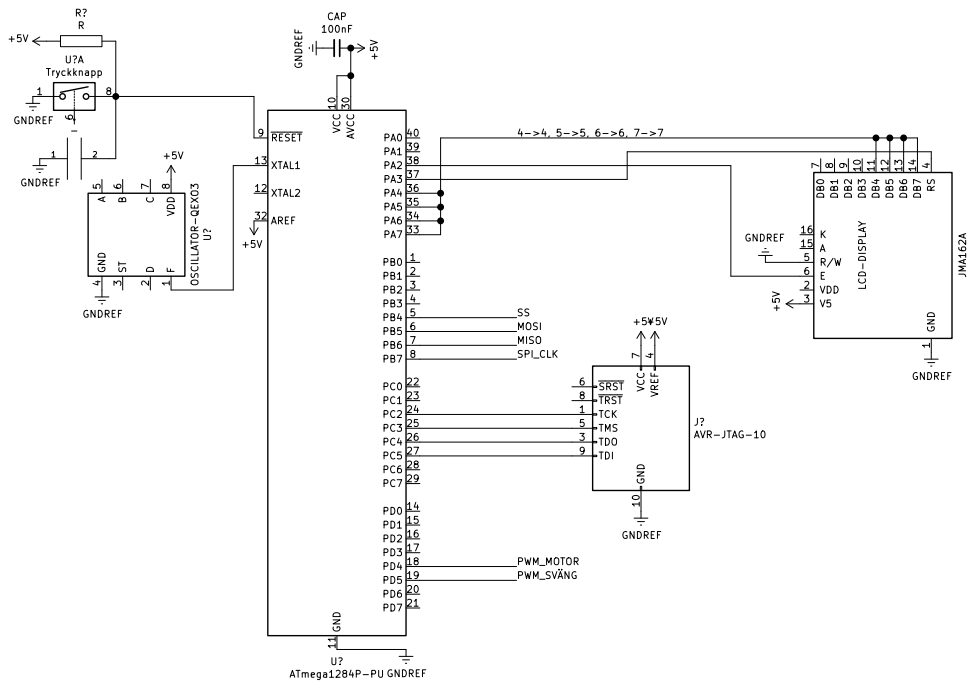
[picture p53: page 1]
