youhas97/autonom-taxi/doc/systemskiss/figures/styrmodul.pdf

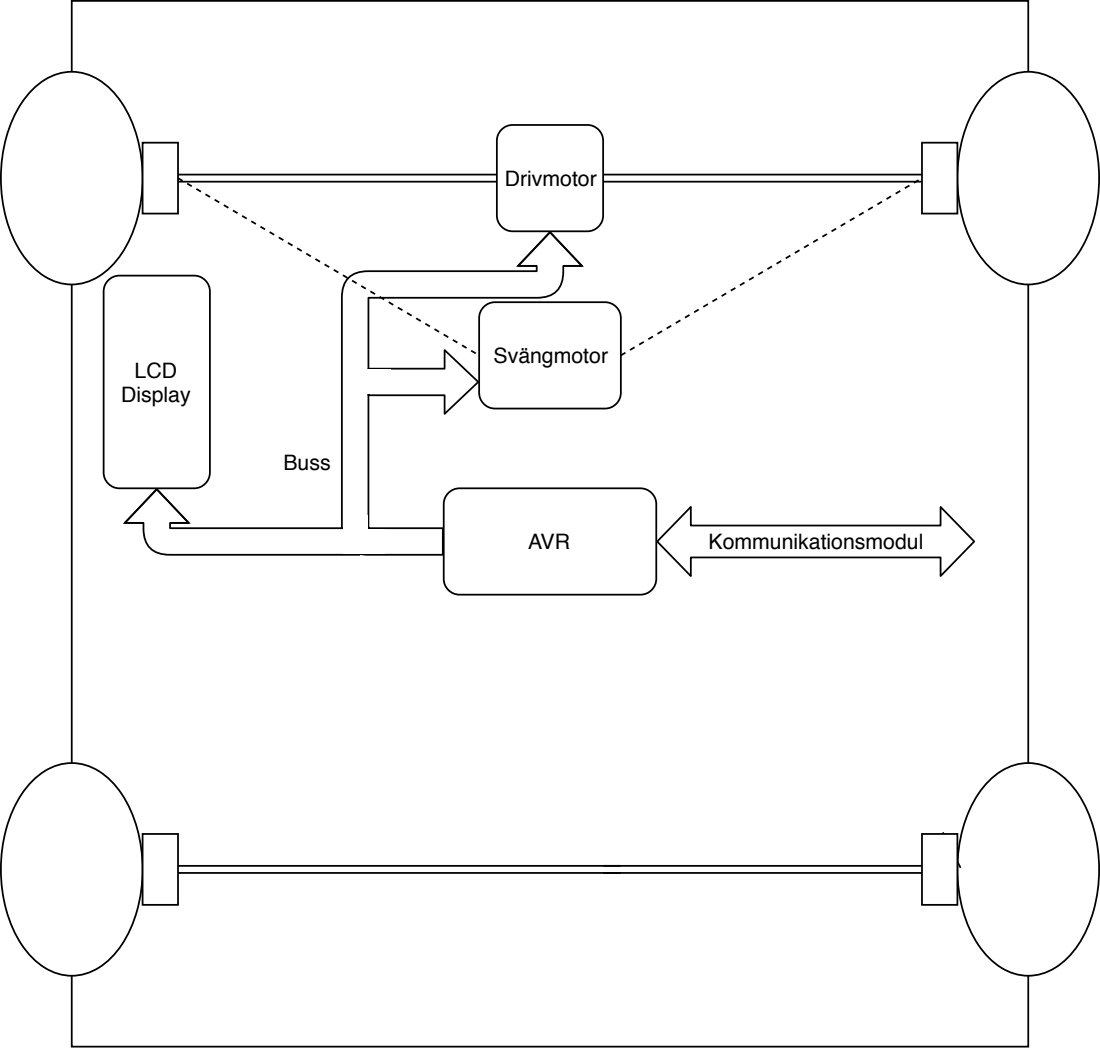
[picture p54: page 1]
AVR; Svängmotor; Drivmotor; Kommunikationsmodul; Buss; LCD Display
