youhas97/autonom-taxi/doc/kravspec/figures/kommunikationsmodul.pdf

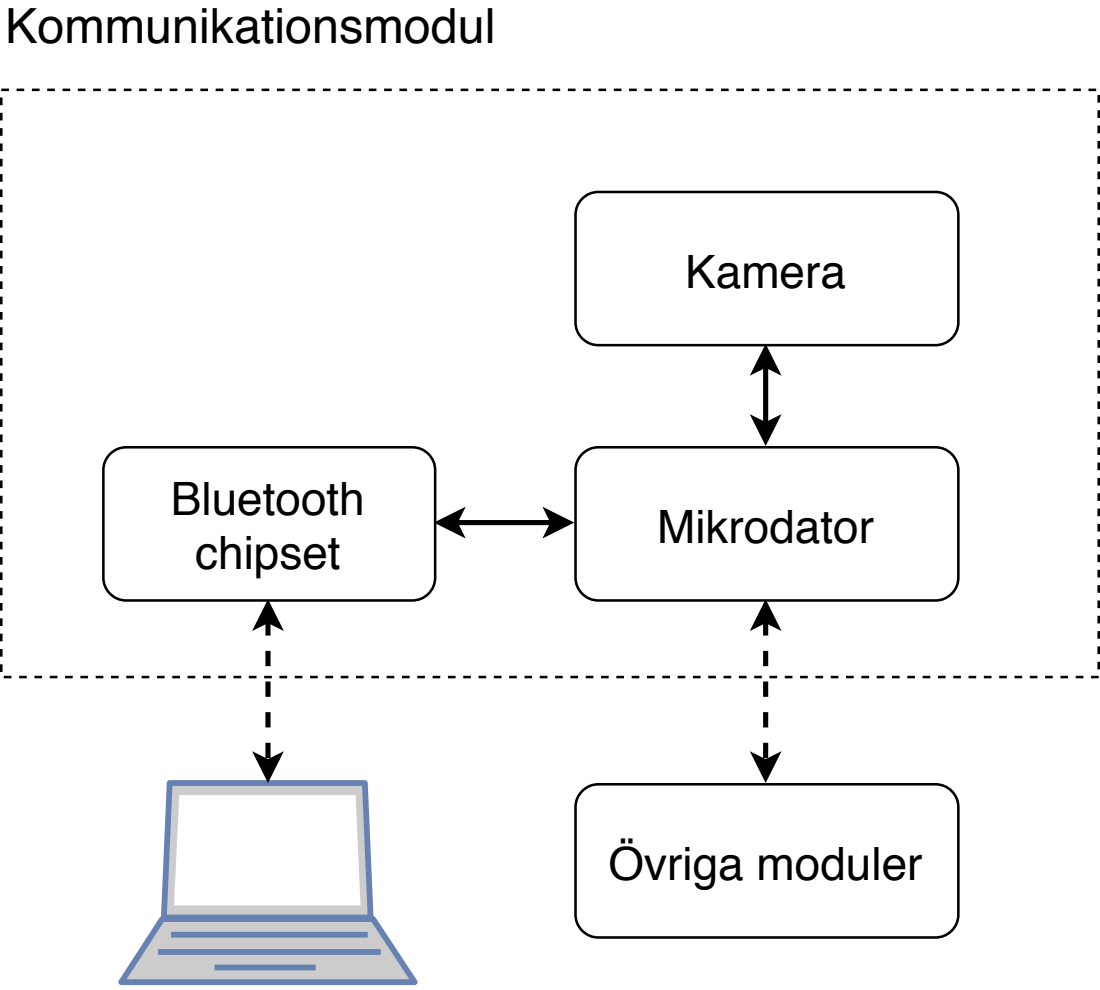
[picture p55: page 1]
Kommunikationsmodul; Mikrodator; Kamera; Övriga moduler; Bluetooth chipset
