youhas97/autonom-taxi/doc/kravspec/figures/styrmodul.pdf

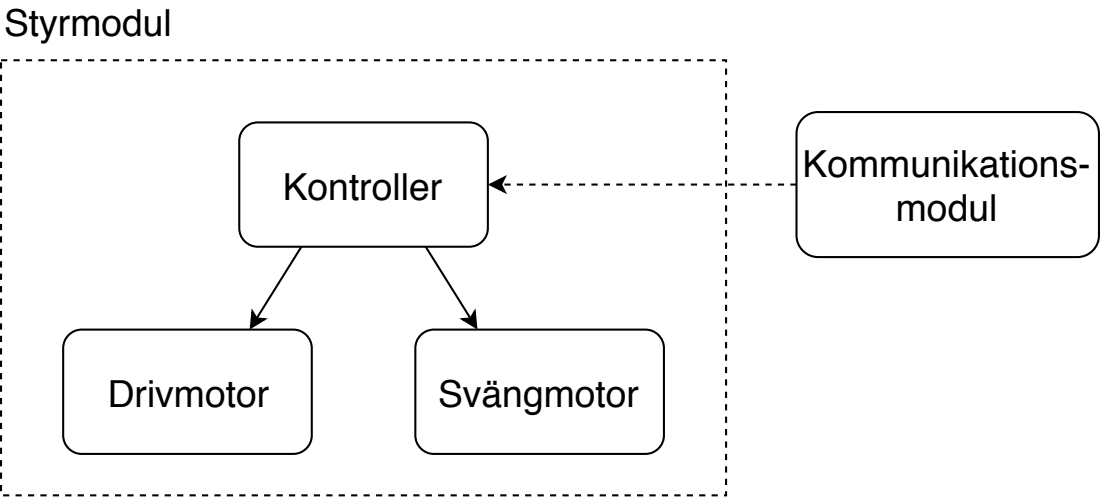
[picture p56: page 1]
Styrmodul; Kontroller; Drivmotor; Svängmotor; Kommunikations- modul
