youhas97/autonom-taxi/doc/usermanual/figures/kretskort-above.pdf

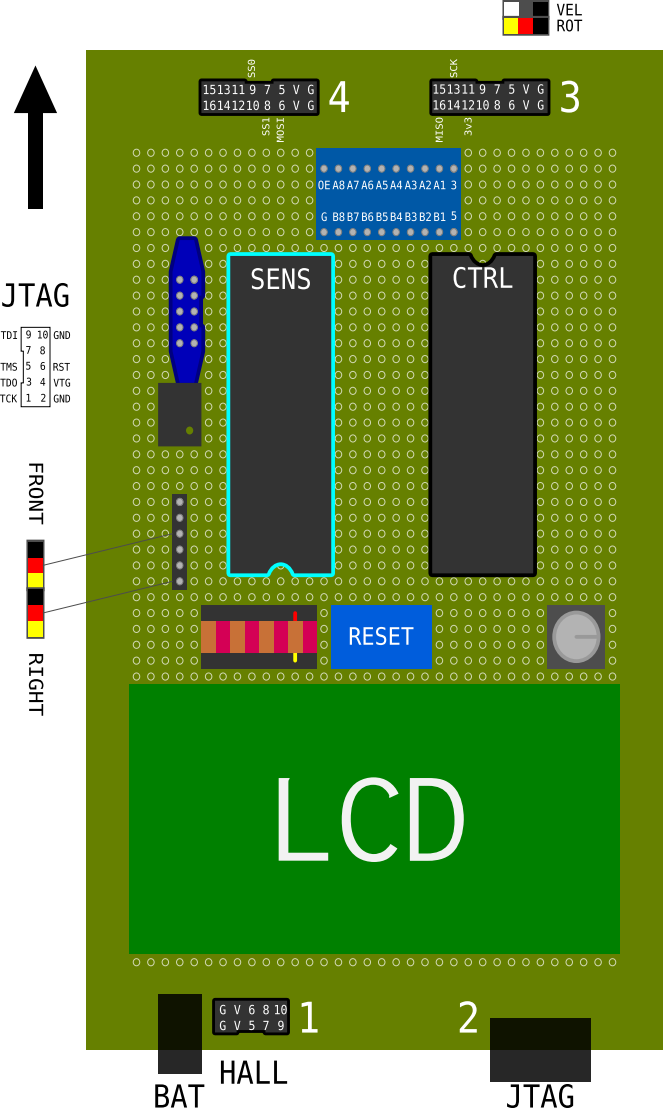
[picture p57: page 1]
