youhas97/autonom-taxi/doc/designspec/diagrams/komm/komm.kicad_pcb

## KiCad design kicad/duet_micro_tool.sch


Parts:
C1, C2: 22p
C3: 22u 50V
C4: 100n 50V; LCSC Part Number C307331
C5: 100n
C6, C7, C8, C10, C13, C14, C16, C17, C19, C21: 100n; LCSC Part Number C307331
C9, C15: 10u
C11: 2n2
C12: 1u
C18, C20: 2u2
D1: M7; LCSC Part Numbert C95872
D2: BLUE
D3: GREEN
J1: Conn_01x04_Male
J2: Conn_01x05_Male
JP1: SolderJumper_2_Open
R1: 22k
R2, R5, R7: 1k
R3: 2k2
R4: 10K
R6: 10k
R8: 120R
U1: ATSAMC21G18A-AUT; TQFP48_7x7MC_MCH
U2: L78M05ABDT-TR; TO-252-2; LCSC Part Number C58069
U3: XC6206P332MR; SOT-23; LCSC Part Number C5446
U4: LIS3DH; LGA-16_3x3mm_P0.5mm_LayoutBorder3x5y; LCSC Part Number C15134
U5: MCP2542FDxMF; DFN-8-1EP_3x3mm_P0.65mm_EP1.55x2.4mm; LCSC Part Number C114028
X1: 25Mhz

Connections:
3.3V: C5.2, C6.2, C8.2, C11.1, C14.1, C15.1, C16.2, C17.1, C18.2, C19.1, C20.1, J2.3, R1.2, R3.1, R4.2, R7.2, U1.4 (PA03), U1.6 (VDDANA), U1.9 (PA04), U1.17 (VDDIO), U1.44 (VDDIN), U3.1 (VO), U4.1 (VDD_IO), U4.2 (NC), U4.8 (CS), U4.14 (VDD), U5.5 (VIO)
5V: C7.1, C9.1, C13.1, C21.2, U2.3 (VO), U3.2 (VI), U5.3 (VDD)
BOARD_TYPE: R1.1, R2.2, U1.10 (PA05)
CAN0_RX: U1.34 (PA25), U5.4 (RXD)
CAN0_TX: U1.33 (PA24), U5.1 (TXD)
CAN-H: J1.3, JP1.2 (B), U5.7 (CANH)
CAN-L: J1.4, R8.2, U5.6 (CANL)
GND: C2.2, C3.2, C4.2, C5.1, C6.1, C7.2, C8.1, C9.2, C10.1, C12.1, C13.2, C14.2, C15.2, C16.1, C17.2, C18.1, C21.1, D2.1 (K), D3.1 (K), J1.2, J2.1, R2.1, U1.5 (GNDANA), U1.18 (GND), U1.42 (GND), U2.2 (GND), U3.3 (GND), U4.5 (GND), U4.10 (GND), U4.12 (GND), U5.2 (VSS), U5.8 (STBY), U5.9 (VSS), X1.2, X1.4
I2C_INT: U1.28 (PA19), U4.11 (INT1)
I2C_SCL: U1.26 (PA17), U4.4 (SCL/SPC)
I2C_SDA: U1.25 (PA16), U4.6 (SDA/SDI/SDO)
LED0: U1.1 (PA00)
unnamed: C1.1, U1.23 (PA14), X1.1
unnamed: C2.1, U1.24 (PA15), X1.3
unnamed: C10.2, C12.2, U1.43 (VDDCORE)
unnamed: C11.2, R4.1, R5.2, U1.40 (~RESET)
unnamed: C19.2, C20.2, U4.13 (ADC3), U4.15 (ADC2), U4.16 (ADC1)
unnamed: D2.2 (A), R6.1
unnamed: D3.2 (A), R7.1
unnamed: JP1.1 (A), R8.1
POWER: C3.1, C4.1, D1.1 (K), R6.2, U2.1 (VI)
RESET: J2.2, R5.1
SWDCLK: J2.4, R3.2, U1.45 (PA30)
SWDIO: J2.5, U1.46 (PA31)
VIN+: D1.2 (A), J1.1

Notes on the sheet:
8VDC to 24VDC
TODO: Verify 5V LDO power
SWD
TODO: VMON signals needed?
TODO: Ok to leave all MPU inputs floating?
