youhas97/autonom-taxi/(commit log)

2018-09-11 currently working on projektidentiet environment
2018-09-11 eh, pulling down brackets
2018-09-13 lägg till sensormodul beskr
2018-09-13 add sensormodul diagram
2018-09-13 add sensorkrav
2018-09-13 add sensormodul picture in file
2018-09-13 add gränssnitt sensormodul
2018-09-13 add sensormodul krav, beskr
2018-09-13 lägg till i sensor module
2018-09-13 barebone skeleton for projektplan, added dokumenttyp and other VARS to kravspec front
    [05Tidplan01.xls]
2018-09-17 Pushing to remote branch emir, current progress on identity
2018-09-17 remove abundant bracket
2018-09-20 add sensorfigure and small fix
2018-09-24 la till prioriteringar och avslut .tex
2018-09-24 la in nya filer i plan.tex
2018-09-24 add empty lines for designspec activities
    [05Tidplan01.xlsx]
2018-09-24 la till inlämningsdatum
2018-09-24 Change format of excel sheet
    [05Tidplan01.xlsx]
2018-09-25 finish tidsplan designfas
    [05Tidplan01.xlsx]
2018-09-26 edit tidsplan
    [05Tidplan01.xlsx]
2018-09-26 Tidplan version 1 should be finished
    [05Tidplan01.xlsx]
2018-09-26 small fixes
    [05Tidplan01.xlsx]
2018-10-01 Specified sensors, defined interface of laptop, changed vars
2018-10-01 finish tidsplan v0.2
    [05Tidplan01.xlsx]
2018-10-02 fix small details
    [05Tidplan01.xlsx]
2018-10-02 c -> python or c, add sensormodul
2018-10-02 commited tidplan, stämmer överens med aktiviter i plan pdf
    [05Tidplan01.xlsx]
2018-10-02 tidplan version 0.2 should be finished
    [05Tidplan01.xlsx]
2018-10-05 la till komponenter.txt
2018-10-05 la till komponenter som kan tänkas vara användbara i modulerna
2018-10-08 add tidsrapport skeleton
    [tidsrapport.xlsx]
2018-10-08 fix tidsplan
    [05Tidplan01.xlsx]
2018-10-08 la till avståndssensor 30cm
2018-10-08 report time for JC, NH, EH & YH
    [05Tidplan01.xlsx, tidsrapport.xlsx]
2018-10-08 log time for JA, JB, DD
    [tidsrapport.xlsx]
2018-10-08 la till komponenter
2018-10-09 log time YH
    [tidsrapport.xlsx]
2018-10-09 Lagt till text undder mjukvaruimplentation i designspecen.
    [tidsrapport.xlsx]
2018-10-11 lägg till timmar i tidsrapport
    [tidsrapport.xlsx]
2018-10-11 log time for everyone
    [tidsrapport.xlsx]
2018-10-11 fix new time plan
    [tidsrapport.xlsx]
2018-10-12 fix typo
    [tidsrapport.xlsx]
2018-10-12 log time for NH, JA, DD, EH, YH
    [tidsrapport.xlsx]
2018-10-15 specificera i2c som proto för main buss, flytta trådlös länk
2018-10-15 add libraries and finish sensormodul kretsschema
    [sens.kicad_pcb, sens.sch, styr.kicad_pcb, styr.sch]
2018-10-15 pidf of sensormodul
2018-10-15 log time everyone
    [tidsrapport.xlsx]
2018-10-15 schematics of raspberry pi lmao
    [komm.kicad_pcb, komm.sch]
2018-10-15 add i2c libraries
2018-10-15 lägg till TODOs, förtydliga motivering för i2c
2018-10-16 lägg till diagram för i2c-bussen
2018-10-16 kicad sucks, uploading pdf of schemtaics of kommunikationsmodul, also uploading black and white versions of schematics
    [komm.sch]
2018-11-01 i2c -> spi, -reflexsensor
2018-11-01 byt ut i2c shifter med spi shifter
2018-11-01 write intro
    [tidsrapport.xlsx]
2018-11-02 add spi bus diagram
2018-11-02 change i2c to SPI
2018-11-02 omformulera, uppdatera sensorer
2018-11-02 översikt klar kanske nu?
    [sens.sch]
2018-11-02 make oscillator in kicad
    [sens.sch]
2018-11-02 Added flowchart
    [tidsrapport.xlsx]
2018-11-02 lägg till pilar spi, skriv om comm SW
2018-11-02 add remote flowchart as appendix
2018-11-04 updated tidsrapport
    [tidsrapport.xlsx]
2018-11-04 sensormodul schema, spi, led display, filters är på g
    [sens.sch]
2018-11-04 Schematics done, need filters for sensors, some resistors for the switches etc
    [komm.sch, sens.sch, styr.sch]
2018-11-04 Forgot that there were 2 halleffektsensors, changed the pins since OC pins are set to specified ports which i needed to free
    [styr.sch]
2018-11-04 pin check subsystem sensors, wrote more on hardware implementaiton of subsystem sensors
2018-11-04 uppdaterar tidsrapport
    [tidsrapport.xlsx]
2018-11-05 add total amount of hours tidsrapport
    [tidsrapport.xlsx]
2018-11-05 update dennis time
    [tidsrapport.xlsx]
2018-11-06 final stage of schematics first assignment
    [komm.sch, sens.sch, styr.sch]
2018-11-06 rm chead, meningskorrigering, ta bort i2c motivation
2018-11-06 change buffer algorithm & fix tidrapport for mattias
    [tidsrapport.xlsx]
2018-11-06 korrigera fel i sensor/styr-modulen
2018-11-06 Updated reset switch for reset and styr
    [sens.sch, styr.sch]
2018-11-07 add comm threads, skeleton files
2018-11-07 add links to pwm & avr c programming
2018-11-07 synchronize bus thread
2018-11-08 motorer -> motor, svängmotor -> svängservo
2018-11-08 motorerna -> motor
2018-11-08 Added LP-filters between sensors
    [sens.sch, styr.sch]
2018-11-08 change pin for pwm motor
2018-11-08 fix styrmodule
    [styr.sch]
2018-11-08 add gnd on r/w
    [styr.sch]
2018-11-08 fix schematic
    [styr.sch]
2018-11-08 update sensors
2018-11-08 Correct pinlist after flowchart change
2018-11-08 Schematics should be finished now, aref fixed and LCD changed to 4 mod pin, lp filters included, capacitator for AVCC aswell
    [sens.sch]
2018-11-08 Fix pinlist in subsys_ctrl
    [tidsrapport.xlsx]
2018-11-08 tidsrapport, uppdaterade alla, juan fixade sig sj en commit innan
    [tidsrapport.xlsx]
2018-11-08 Fixed pins on LCD in sens
    [sens.sch]
2018-11-08 crop komm mod
    [komm.sch]
2018-11-08 fixed styrpins to 4 mod databuss instead, adde more info about lcd in subsection styr_ctrl
    [styr.sch]
2018-11-08 edit pins in sensor & edit granskare
2018-11-09 add initializer for spi & pwm in ctrl
2018-11-09 close sockets
2018-11-10 update times
    [tidsrapport.xlsx]
2018-11-11 add opencv live camera guide link
2018-11-11 update timeplan for the week
    [tidsrapport.xlsx]
2018-11-12 uppdaterar tidsplan må v46, virade jtag och lcd på sensor, ingen matning eller jord ännu, planerade lite hur det skulle staplas.
    [tidsrapport.xlsx]
2018-11-13 use only posix standard threading types (rwlock -> mutex)
2018-11-13 fix komm kretsschema
    [komm.sch]
2018-11-13 spi software done
2018-11-13 fix pwm port & pd loop
    [ctrl.c]
2018-11-13 log time
    [tidsrapport.xlsx]
2018-11-13 log time JA, YH
    [tidsrapport.xlsx]
2018-11-13 Revert "begin impl of commands"
    This reverts commit 9b1062bf721080fbb4b9f2db9be011941458903d.
    [main.c]
2018-11-14 mv sim header to separate file, fix Makefile for sim
    [ctrl.c]
2018-11-15 Added adc
2018-11-15 add adc resource
2018-11-15 add formula for front ir sensor
2018-11-15 update time
    [tidsrapport.xlsx]
2018-11-15 adjust sensor value conversion constants
2018-11-16 update time juan & yo
    [tidsrapport.xlsx]
2018-11-16 make the car run with pwm & upate simconfig
2018-11-16 implement server command execution, response with threading
2018-11-16 update worktime
    [tidsrapport.xlsx]
2018-11-16 begin ISR for spi
2018-11-17 tidsrapporterade för hela veckan
    [tidsrapport.xlsx]
2018-11-18 add str helper, fix memory leaks, rewrite cmds with helper
    [main.c]
2018-11-18 send regulator parameters to ctrl on demand from remote
2018-11-18 add resource about tkinter threading
2018-11-19 rapportera tid v46
    [tidsrapport.xlsx]
2018-11-19 use variable length for spi tranceive
2018-11-19 mv common spi declarations to spi/protocol
2018-11-19 edit timeplan for the week
    [tidsrapport.xlsx]
2018-11-19 edit ISR for spi
2018-11-19 setup spi, fix spi pins
    [main.c]
2018-11-19 tidsrapport för mig sj och en 1timma möte för alla andra
    [tidsrapport.xlsx]
2018-11-19 Improve GUI
    [tidsrapport.xlsx]
2018-11-20 working code with camera size 640x480
2018-11-20 trying to handle sensor data when interrupt
2018-11-20 decode and use only latest frame
2018-11-20 small fixes to beable to make sens
    [sens.c]
2018-11-20 print on error
2018-11-20 GUI Set state
    [tidsrapport.xlsx]
2018-11-20 use double value for spi to ctrl, rewrite ctrl ISR for SPI
2018-11-21 added wheel sensor and its interrupts
2018-11-21 ctrl: limit velocity and rotation
2018-11-21 update variable names, fix typos and small errors
    [sens.c]
2018-11-21 use regulator, set default constants
2018-11-21 fix regulator command
2018-11-21 update emir time
    [tidsrapport.xlsx]
2018-11-21 lower spi clock
2018-11-21 GUI create map
    [tidsrapport.xlsx]
2018-11-22 fix using vel max for all values
    [ctrl.c]
2018-11-22 restore min values, fix typo
    [ctrl.c]
2018-11-22 change resolution of camera in opencv
2018-11-22 fuck lsd, moving on, gdb sensor values
2018-11-22 impl error checking for bus
    [ctrl.c, main.c, sens.c]
2018-11-22 tidrapport noah, emir, juan
    [tidsrapport.xlsx]
2018-11-23 barebone skeleton for rs232, uart to computer
2018-11-23 1: Lines are being printed again. 2: Solved fitLine() problem
2018-11-23 rm print
2018-11-23 try to set fps to 90 and print default/used fps
2018-11-23 synchronize wheel interrupts
2018-11-23 set spi freq 700k
2018-11-23 GUI save/open map to file
    [tidsrapport.xlsx]
2018-11-23 uppdatera Dennis timmar.
    [tidsrapport.xlsx]
2018-11-25 use wiringPi channels/cs properly
2018-11-25 add connections, fix uncertanties with connectors, rst
2018-11-25 fix errors, debug spi
2018-11-25 remove ack at start, no longer used
    [main.c]
2018-11-25 use linux api directly for SPI instead of wiringPi
2018-11-25 fix sync errors, clean up
    [ctrl.c]
2018-11-26 LCD working, implement scrolling print string
2018-11-26 update timeplan
    [tidsrapport.xlsx]
2018-11-26 writing code for sensors in lcd debug environment, stuck with converting float to string value
    [lcd_lcd.c]
2018-11-26 tidsarpport, virat hela dagen och skrivit lite kod för lcd och sensorer
    [tidsrapport.xlsx]
2018-11-26 GUI display speed
    [tidsrapport.xlsx]
2018-11-27 add grounds
2018-11-27 Revert "GUI display speed"
    This reverts commit e2489c40cf3814d46c93a9b256385e1fb4ed84b0.
    [tidsrapport.xlsx]
2018-11-27 Fixed scrolling on lcd, it didnt work for strings longer than 32 chars before
    [lcd_lcd.c]
2018-11-27 row flag in lcd switched place when solving merge
2018-11-27 fix server segmentation fault
    [main.c]
2018-11-27 GUI Position of windows
    [tidsrapport.xlsx]
2018-11-27 comm.ip fix debug compile errors
    [main.c]
2018-11-27 removed some unnecessary macros from lcd.c, lcd works now, started measuring values from sensors
2018-11-28 move motor conectors to match actual card
2018-11-28 change break to brake, add comments on vars
2018-11-28 move motor connectors, corrections
2018-11-28 GUI select nodes for create edge
    [tidsrapport.xlsx]
2018-11-28 add time
    [tidsrapport.xlsx]
2018-11-29 wip obj struct redesign
    [main.c]
2018-11-29 actually fix compile issues
    [main.c]
2018-11-29 GUI fix Same edge, edge without nodes, same node, enter cmd
    [tidsrapport.xlsx]
2018-11-30 debug spi synchronization
2018-11-30 synchronize spi when out of sync
2018-11-30 printing leftline, changing back error value
2018-11-30 printing start.x end.x
2018-11-30 GUI FIX: Mode button, edge arrows, negative cost, set mission
2018-11-30 sc: format sensor values
2018-11-30 create obj_execute, keep track of stopline time
2018-11-30 remove extra print
2018-12-01 comm: mv low level spi to separate file
2018-12-02 mv spi freq to comm main
2018-12-02 tidsrapportering noah v48
    [tidsrapport.xlsx]
2018-12-03 lägga till dennis tid
    [tidsrapport.xlsx]
2018-12-03 write to sensor_values from sensor data
2018-12-03 ctrl: adjust default regulator constants
2018-12-04 add lcd functions to sens.c & fix cm conversion
    [sens.c]
2018-12-04 print distance to lcd
2018-12-04 udate time
    [tidsrapport.xlsx]
2018-12-04 ip: record opencv frames to file (untested)
2018-12-04 ip: fix recording to file, add comments, add mask to frame
2018-12-05 adjust wheel constants; remove lcd delay
2018-12-05 experiment with spi interrupt solution
2018-12-05 avr bus: optionally enable interrupt
2018-12-05 comm: fix bsh deadlock
    [main.c]
2018-12-05 debug spi int
2018-12-05 GUI Add error print, fix kp/kd
2018-12-05 fix SPI retriveing
2018-12-05 comm: fix time and velocity calculation
    [main.c]
2018-12-05 fix distance multiplier magnitude
    [sens.c]
2018-12-06 ip: remove currently unused code, revert if needed later
2018-12-06 disable kill switch
2018-12-06 comm: fix spi loss with delay, add bus sync function
    [main.c]
2018-12-06 Tidsrapport, makefiles, mallar, over 900h in inkscape. spent time 3D CAD:ing, learning about pcbs, eaglecad etc
    [tidsrapport.xlsx]
2018-12-07 GUI Working with pos in map #
    [tidsrapport.xlsx]
2018-12-07 adjust kp, kd, set velocity in m/s
2018-12-08 comm: allow empty mission for reset
    [main.c]
2018-12-08 comm: error handling, create sample rule
    [main.c]
2018-12-08 destroy muteces, rm debug print
2018-12-08 ip: adjust constants from sample, calc lane dir by summing side lines
2018-12-08 make: add visual sample rule
2018-12-08 ctrl: reset error on direct value command
    [ctrl.c]
2018-12-08 ctrl: add integration part to PID
2018-12-08 comm: calculate error for regulation, stop for obstacle
    [main.c]
2018-12-09 fix velocity calc, fix setting direct velocity
    [main.c]
2018-12-09 reset avr on shutdown, disable vel regulation
    [main.c]
2018-12-09 rm debug print
2018-12-10 timeplan for this week
    [tidsrapport.xlsx]
2018-12-10 comm: send placeholder error
    [main.c]
2018-12-10 spi: add velocity to sens data
2018-12-10 sens: calc velocity
2018-12-10 comm: send lane error to remote, synchronize obj properly
    [main.c]
2018-12-11 obj: fix wrong if case for park after stop
2018-12-11 ctrl: disable unused interrupt, use correct type to accept
    [ctrl.c]
2018-12-11 spi: add ack to receive
2018-12-11 replace if else with switch case
    [sens.c]
2018-12-11 fix velocity sensor
2018-12-11 sens: use only left wheel for velocity
2018-12-11 ctrl: adjust vel k for full battery
2018-12-11 comm: use sens velocity instead of rpi estimate
2018-12-11 comm: do not print packet loss
2018-12-11 avr: set slave in ctrl/bus, prevent needing clean
    [ctrl.c, sens.c]
2018-12-11 comm: brake for obstacle
2018-12-11 obj: break with current vel, adjust parking, ignore left before exit
2018-12-11 send and display motor values for remote
2018-12-11 get mission returns list of current commands
2018-12-11 obj: correct velocity
2018-12-12 techdoc: update wireless protocol
2018-12-12 sensor file
2018-12-13 update sens module schematic
    [sens.sch]
2018-12-13 Revert "update sens module schematic"
    This reverts commit 18ae42b13ac670fb9527cdf2e035fc7bce516c1b.
    [sens.sch]
2018-12-13 update schematic in tech
2018-12-13 add text about representation of mission and map
    [styr.sch]
2018-12-13 Sequence diagram for remote control user press button up
2018-12-13 update pin numbers lcd
    [styr.sch]
2018-12-13 update sensor mod schematic
    [sens.sch]
2018-12-13 Doc, Done with GUI and worker threading i think
2018-12-13 Refurbished some sentences in remote thread, removed last sentence
2018-12-13 tech: add original opencv frame
2018-12-14 make: add rule to plot velocity data
2018-12-14 sens: improve velocity measuring; allow plot of velocity
